PecaJosef/PCK-ST1/RPi Zero Software/pckdev/img.jpg

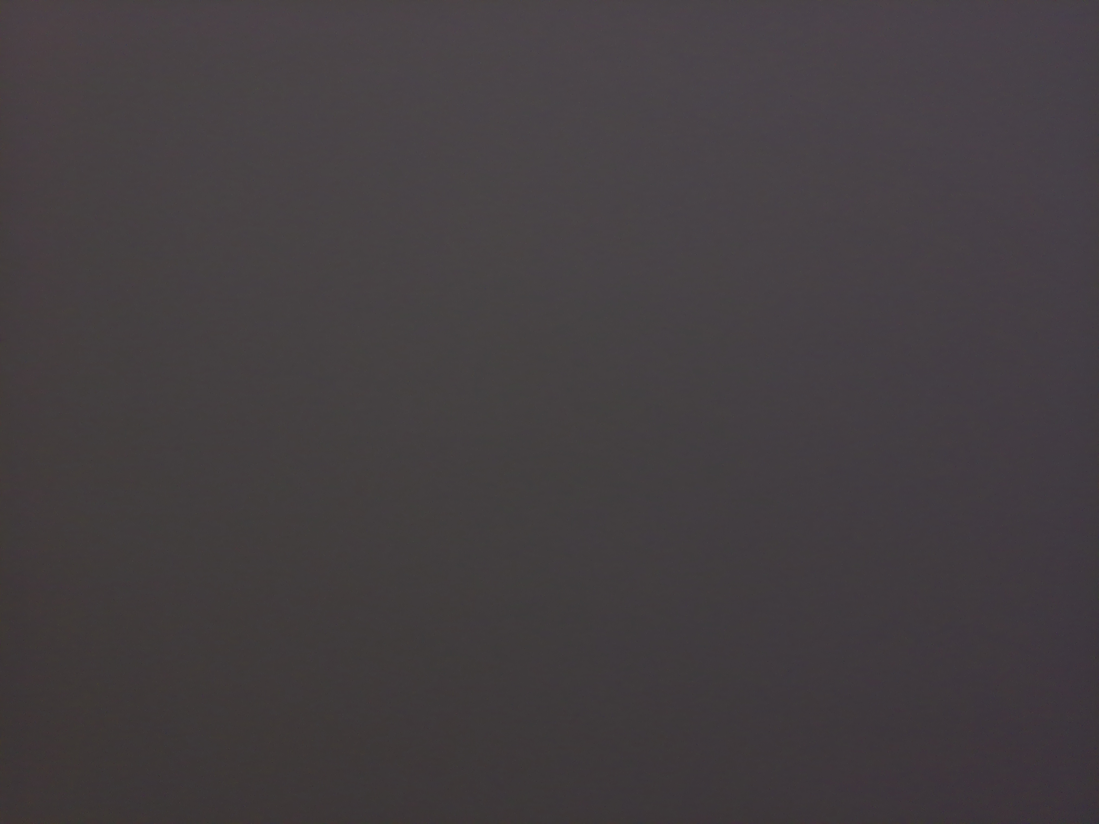
RPi Zero Software/pckdev/img.jpg
