PecaJosef/PCK-ST1/README.md

# PCK-ST1
Star tracker with automatic polar alignment
