PecaJosef/PCK-ST1/RPi Zero Software/pckdev/ncp_output.jpg

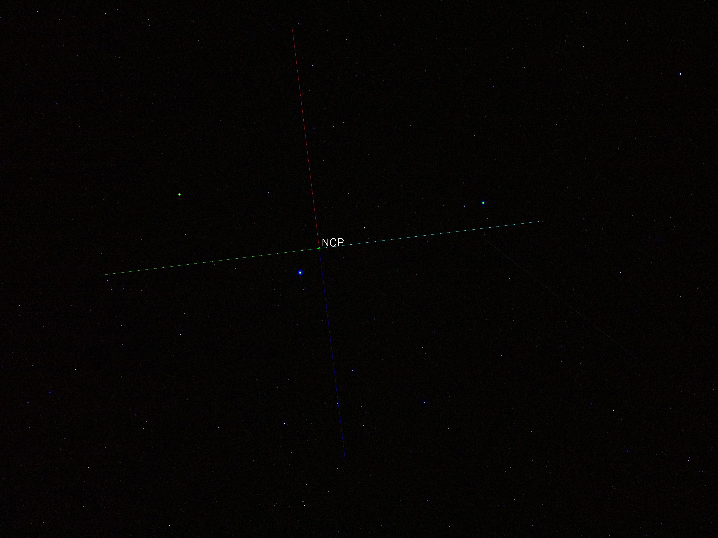
RPi Zero Software/pckdev/ncp_output.jpg
