PecaJosef/PCK-ST1/RPi Zero Software/pckdev/star_img/polaris4_1.jpg

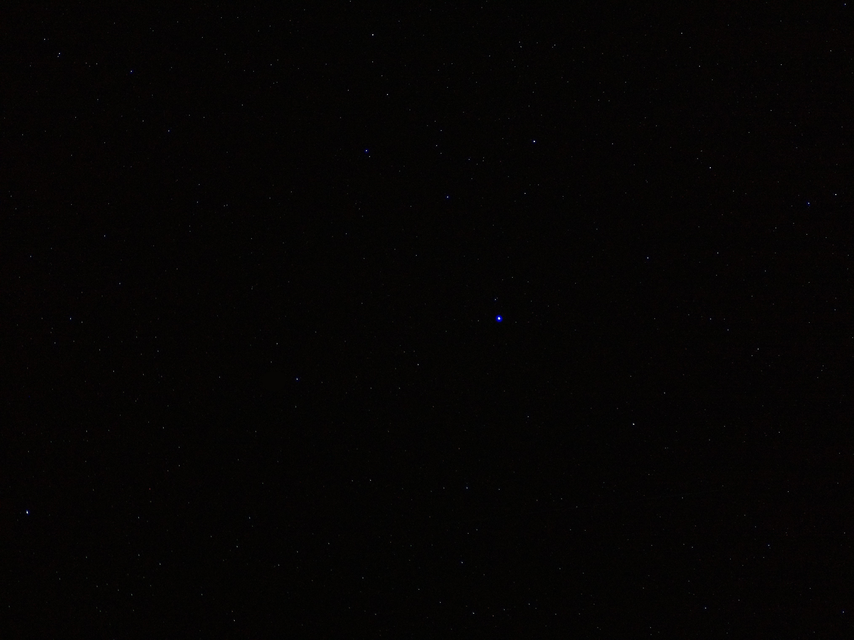
RPi Zero Software/pckdev/star_img/polaris4_1.jpg
