PecaJosef/PCK-ST1/Camera connector/Camera_connector_board/Camera_connector_board.step

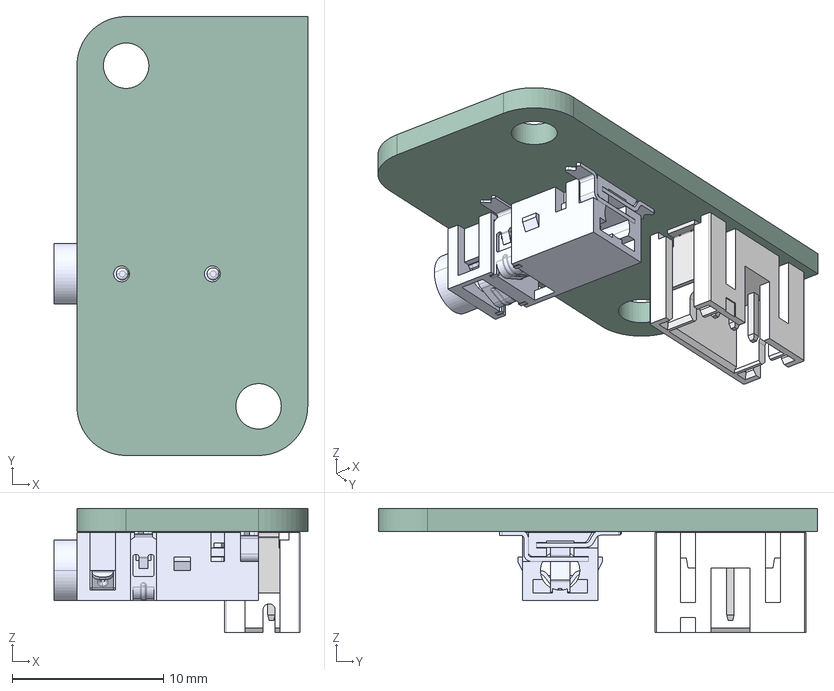
[picture p4: CAD file, 2026-01-14]
Camera connector/Camera_connector_board/Camera_connector_board.step
16.8 x 29.0 x 8.20 mm
B3B-PH-SM4-TB_LF__SN_
SJ-2524-SMT-TR
Camera_connector_board_PCB
