PecaJosef/PCK-ST1/Connector board/V0.2/Connector_board.step

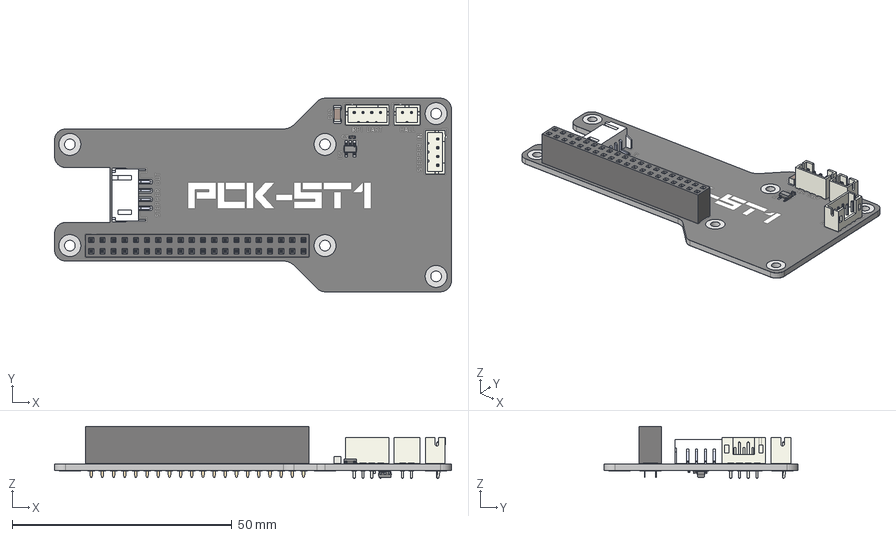
[picture p5: CAD file, 2026-02-14]
Connector board/V0.2/Connector_board.step
90.2 x 44.0 x 11.9 mm
JST_PH_B4B-PH-K_1x04_P2.00mm_Vertical x 2
JST_PH_B2B-PH-K_1x02_P2.00mm_Vertical
PinSocket_2x20_P2.54mm_Vertical
C_0402_1005Metric x 3
PinsArrayL
PinsArrayR
S4B-PH-SM4-TB_LF__SN_
C_1206_3216Metric
PinsArrayLR
R_0402_1005Metric
Connector_board_pad
Connector_board_silkscreen x 2
Connector_board_soldermask x 2
Connector_board_PCB
