PecaJosef/PCK-ST1/Hall effect endstop/PCK-HALL.step

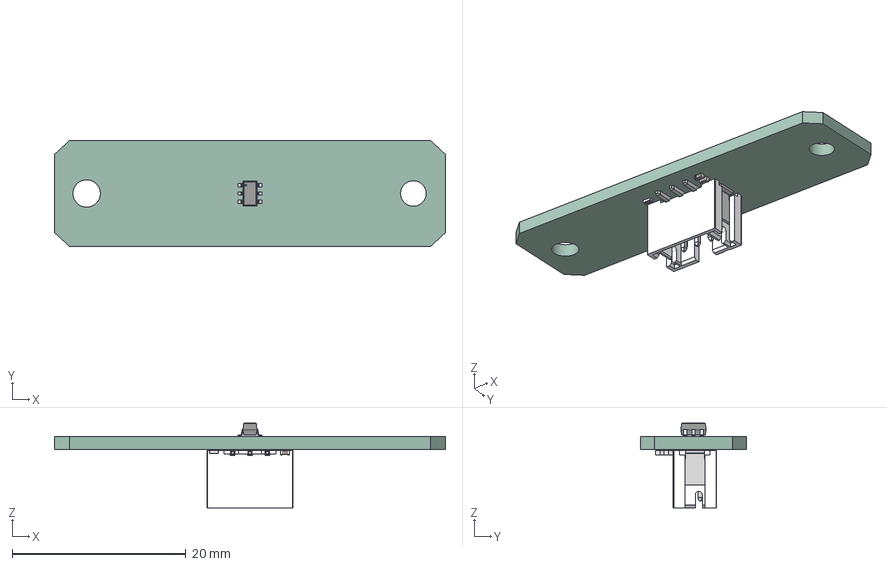
[picture p6: CAD file, 2026-01-14]
Hall effect endstop/PCK-HALL.step
45.0 x 12.2 x 9.73 mm
PinsArrayLR
B3B-PH-SM4-TB_LF__SN_
C_0402_1005Metric x 2
R_0402_1005Metric
PCK-HALL_PCB
