PecaJosef/PCK-ST1/Main board/Sketch515.dxf

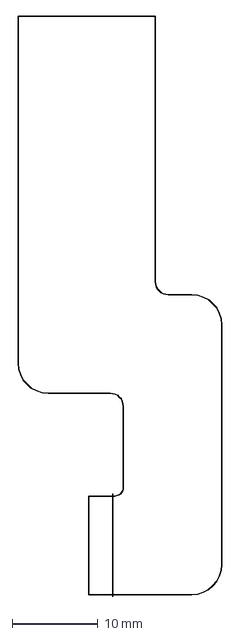
[picture p7: CAD file, 2025-07-25]
Main board/Sketch515.dxf
23.7 x 67.7 mm
