PecaJosef/PCK-ST1/Flexible camera cable v2/V2.0/PCK_Flex.step

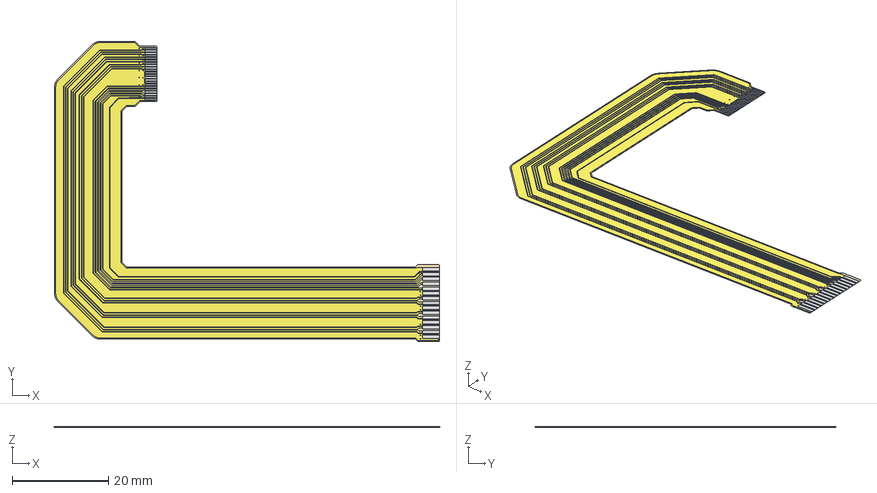
[picture p8: CAD file, 2026-02-14, an earlier design]
Flexible camera cable v2/V2.0/PCK_Flex.step
79.8 x 62.2 x 0.054 mm
PCK_Flex_copper
PCK_Flex_pad
PCK_Flex_via
PCK_Flex_PCB
