PecaJosef/PCK-ST1/Connector board/V0.2/Connector_board.kicad_pcb

## KiCad design Connector board/V0.2/Connector_board.kicad_pcb (2026-03-19)

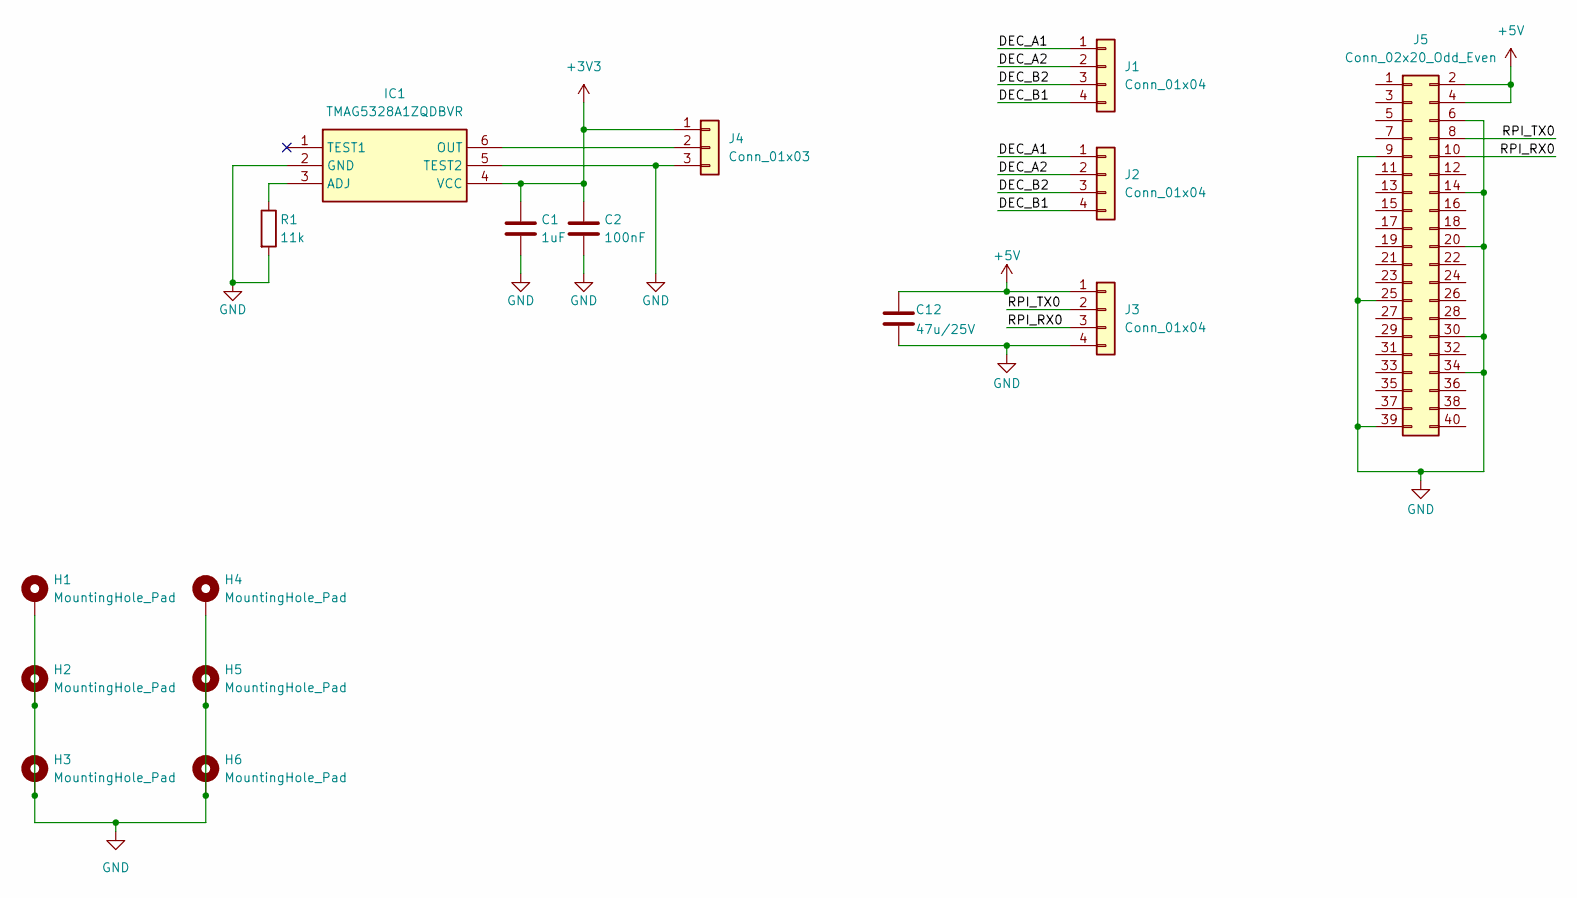
[picture p9: schematic Connector_board.kicad_sch]

Parts:
C1: 1uF; C_0402_1005Metric
C2: 100nF; C_0402_1005Metric
C12: 47u/25V; C_1206_3216Metric; Part Number C3216X5R1E476M160AC
H1, H2, H3, H4, H5, H6: MountingHole_Pad; MountingHole_2.5mm_Pad
IC1: TMAG5328A1ZQDBVR; SOT95P280X145-6N; Manufacturer_Part_Number TMAG5328A1ZQDBVR
J1, J3: Conn_01x04; JST_PH_B4B-PH-K_1x04_P2.00mm_Vertical
J2: Conn_01x04; JST_PH_S4B-PH-SM4-TB_1x04-1MP_P2.00mm_Horizontal
J4: Conn_01x03; JST_PH_B3B-PH-K_1x03_P2.00mm_Vertical
J5: Conn_02x20_Odd_Even; PinSocket_2x20_P2.54mm_Vertical
R1: 11k; R_0402_1005Metric

Connections:
+3V3: C1.1, C2.1, IC1.4 (VCC), J4.1
+5V: C12.1, J3.1, J5.2, J5.4
/DEC_A1: J1.1, J2.1
/DEC_A2: J1.2, J2.2
/DEC_B1: J1.4, J2.4
/DEC_B2: J1.3, J2.3
/RPI_RX0: J3.3, J5.10
/RPI_TX0: J3.2, J5.8
GND: C1.2, C2.2, C12.2, H1.1, H2.1, H3.1, H4.1, H5.1, H6.1, IC1.2 (GND), IC1.5 (TEST2), J3.4, J4.3, J5.6, J5.9, J5.14, J5.20, J5.25, J5.30, J5.34, J5.39, R1.2
unnamed: IC1.3 (ADJ), R1.1
unnamed: IC1.6 (OUT), J4.2

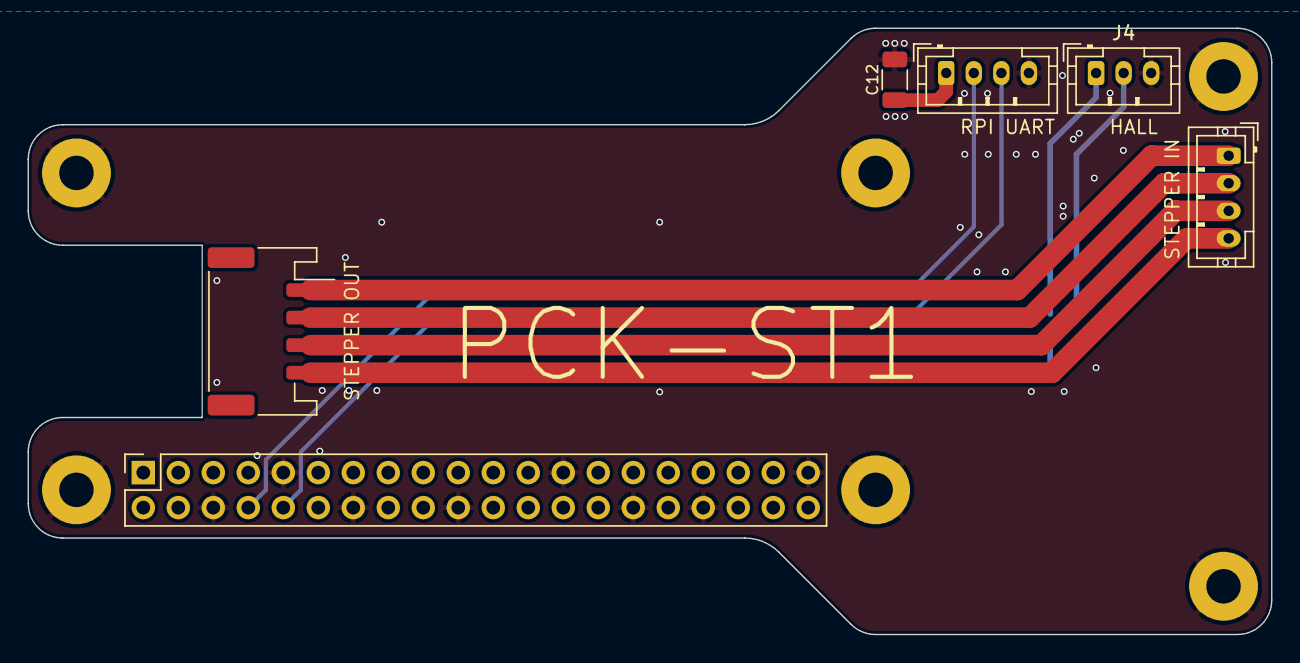
[picture p10: board Connector_board.kicad_pcb from above]

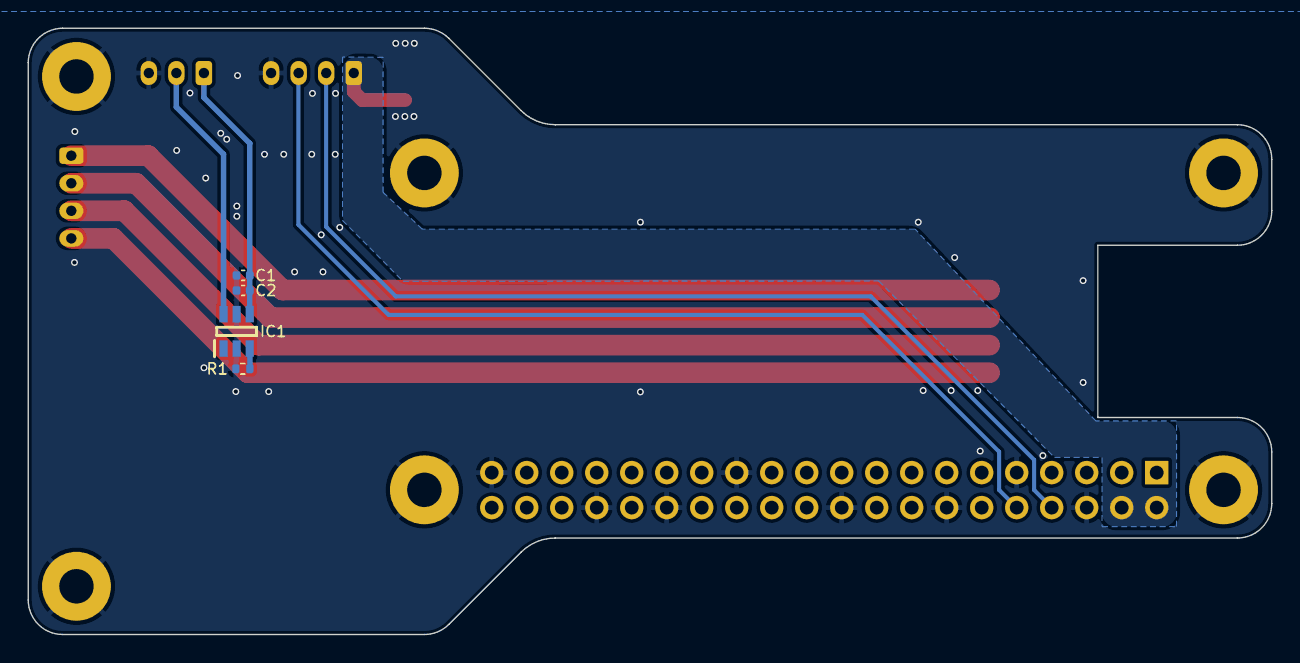
[picture p11: board Connector_board.kicad_pcb from below]

Board: 2 copper layers, 90.2 x 44.0 mm, 16 parts (4 on the bottom side), 11 nets.
