PecaJosef/PCK-ST1/Main board/PCK-ST1.kicad_pcb

## KiCad design Main board/PCK-ST1.kicad_pcb (2026-03-15)

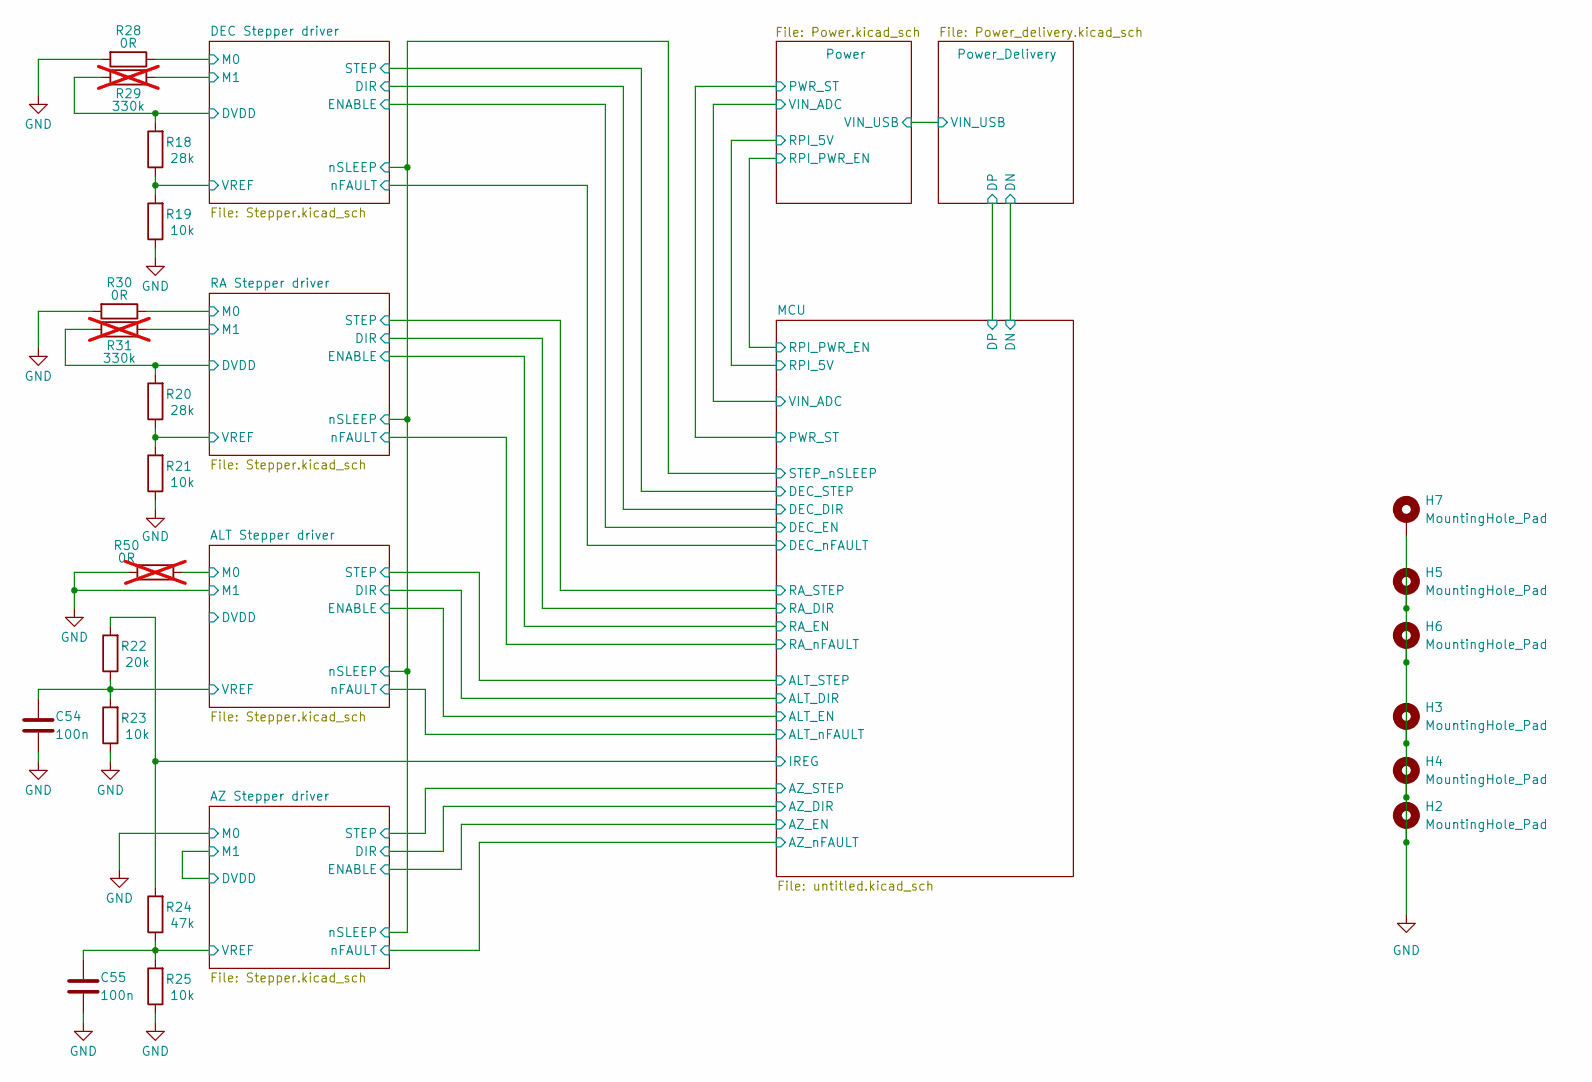
[picture p12: schematic PCK-ST1.kicad_sch]

Parts:
C54, C55: 100n; C_0402_1005Metric; Part Number GRM155R71C104JA88D
H2, H3, H4, H5, H6, H7: MountingHole_Pad; MountingHole_2.7mm_M2.5_DIN965_Pad
R18, R20: 28k; R_0402_1005Metric; Part Number CRCW040228K0FKED
R19, R21, R23, R25: 10k; R_0402_1005Metric; Part Number CRCW040210K0FKEDC
R22: 20k; R_0402_1005Metric; Part Number CRCW040220K0FKEDHP
R24: 47k; R_0402_1005Metric; Part Number CRCW040247K0FKED
R28, R30: 0R; R_0402_1005Metric; Part Number CRCW04020000Z0EDC
R29, R31: 330k; R_0402_1005Metric; Part Number CRCW0402330KFKED; not fitted
R50: 0R; R_0402_1005Metric; Part Number CRCW04020000Z0EDC; not fitted

Connections:
/ALT Stepper driver/M0: R50.2; also elsewhere on the board
/ALT Stepper driver/VREF: C54.1, R22.1, R23.2; also elsewhere on the board
/AZ Stepper driver/VREF: C55.1, R24.1, R25.2; also elsewhere on the board
/DEC Stepper driver/DVDD: R18.2, R29.1; also elsewhere on the board
/DEC Stepper driver/M0: R28.1; also elsewhere on the board
/DEC Stepper driver/M1: R29.2; also elsewhere on the board
/DEC Stepper driver/VREF: R18.1, R19.2; also elsewhere on the board
/MCU/IREG: R22.2, R24.2; also elsewhere on the board
/RA Stepper driver/DVDD: R20.2, R31.1; also elsewhere on the board
/RA Stepper driver/M0: R30.1; also elsewhere on the board
/RA Stepper driver/M1: R31.2; also elsewhere on the board
/RA Stepper driver/VREF: R20.1, R21.2; also elsewhere on the board
GND: C54.2, C55.2, H2.1, H3.1, H4.1, H5.1, H6.1, H7.1, R19.1, R21.1, R23.1, R25.1, R28.2, R30.2, R50.1; also elsewhere on the board

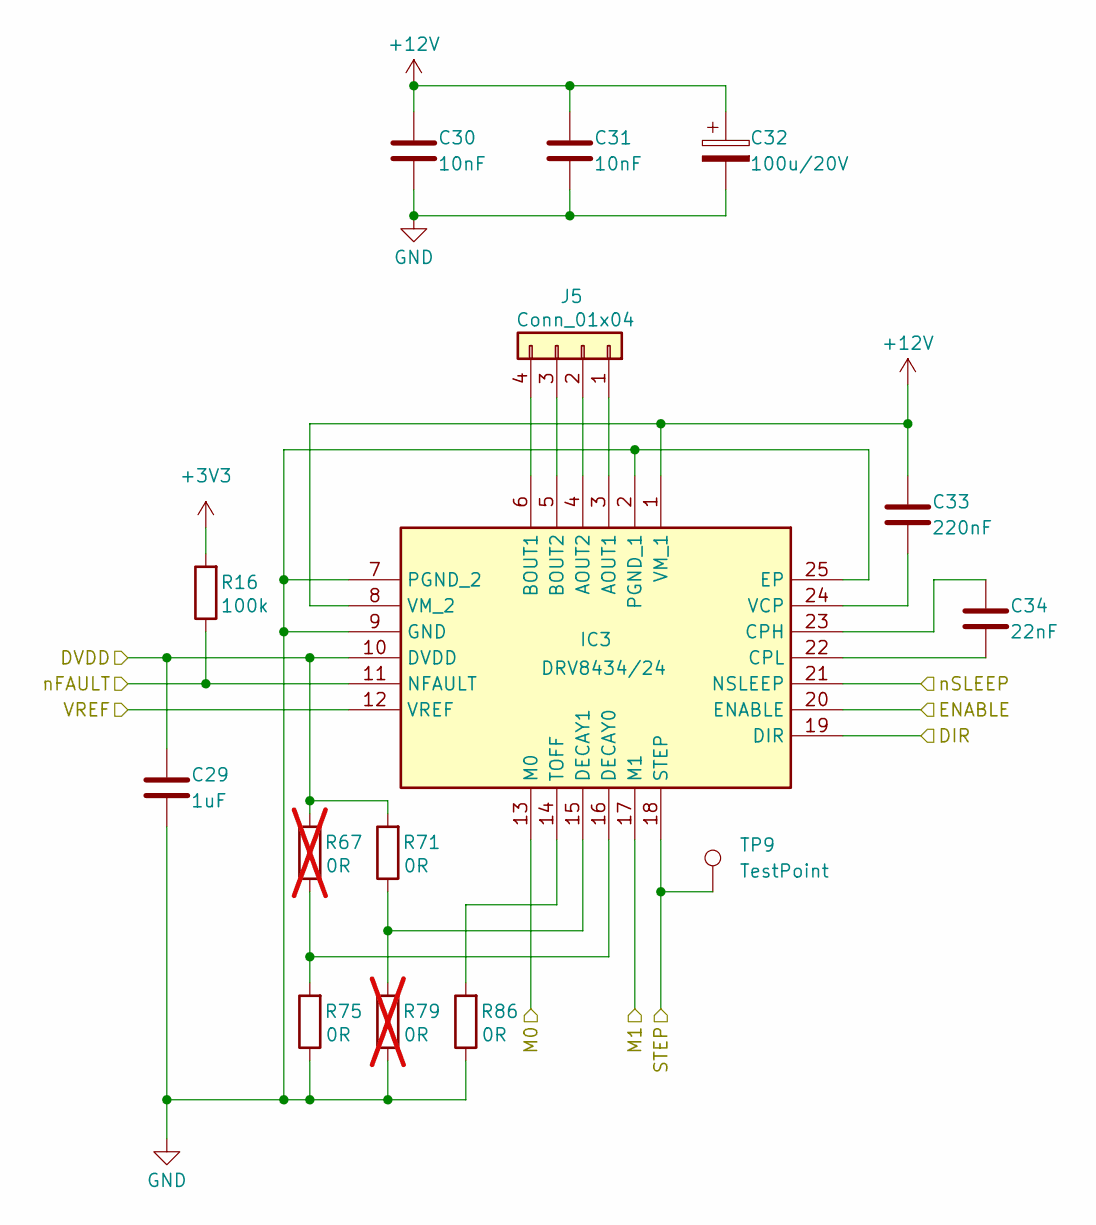
[picture p13: schematic Stepper.kicad_sch]

Parts:
C29: 1uF; C_0402_1005Metric; Part Number GRM155Z71A105KE01J
C30, C31: 10nF; C_0402_1005Metric; Part Number GRM155R71H103JA88D
C32: 100u/20V; CP_EIA-7343-15_Kemet-W; Part Number 293D107X9020D2TE3
C33: 220nF; C_0402_1005Metric; Part Number GCM155R71C224KE02J
C34: 22nF; C_0402_1005Metric; Part Number GRM155R71E223JA61D
IC3: DRV8434/24; QFN50P400X400X100-25N-D; Mouser Part Number DRV8434RGER
J5: Conn_01x04; JST_PH_B4B-PH-K_1x04_P2.00mm_Vertical
R16: 100k; R_0402_1005Metric; Part Number CRCW0402100KFKEE
R67, R79: 0R; R_0402_1005Metric; Part Number CRCW04020000Z0EDC; not fitted
R71, R75, R86: 0R; R_0402_1005Metric; Part Number CRCW04020000Z0EDC
TP9: TestPoint; TestPoint_Pad_D1.0mm

Connections:
+3V3: R16.2; also elsewhere on the board
+12V: C30.1, C31.1, C32.1, C33.1, IC3.1 (VM_1), IC3.8 (VM_2); also elsewhere on the board
/ALT Stepper driver/DIR: IC3.19 (DIR); also elsewhere on the board
/ALT Stepper driver/DVDD: C29.1, IC3.10 (DVDD), R67.2, R71.2
/ALT Stepper driver/ENABLE: IC3.20 (ENABLE); also elsewhere on the board
/ALT Stepper driver/M0: IC3.13 (M0); also elsewhere on the board
/ALT Stepper driver/STEP: IC3.18 (STEP), TP9.1; also elsewhere on the board
/ALT Stepper driver/VREF: IC3.12 (VREF); also elsewhere on the board
/ALT Stepper driver/nFAULT: IC3.11 (NFAULT), R16.1; also elsewhere on the board
/ALT Stepper driver/nSLEEP: IC3.21 (NSLEEP); also elsewhere on the board
GND: C29.2, C30.2, C31.2, C32.2, IC3.2 (PGND_1), IC3.7 (PGND_2), IC3.9 (GND), IC3.17 (M1), IC3.25 (EP), R75.1, R79.1, R86.1; also elsewhere on the board
unnamed: IC3.3 (AOUT1), J5.1
unnamed: IC3.4 (AOUT2), J5.2
unnamed: IC3.6 (BOUT1), J5.4
unnamed: IC3.5 (BOUT2), J5.3
unnamed: C34.1, IC3.23 (CPH)
unnamed: C34.2, IC3.22 (CPL)
unnamed: IC3.16 (DECAY0), R67.1, R75.2
unnamed: IC3.15 (DECAY1), R71.1, R79.2
unnamed: IC3.14 (TOFF), R86.2
unnamed: C33.2, IC3.24 (VCP)

Parts of its further copies:
C15, C28, C40: 22nF; C_0402_1005Metric; Part Number GRM155R71E223JA61D
C16, C23, C35: 1uF; C_0402_1005Metric; Part Number GRM155Z71A105KE01J
C17, C27, C39: 220nF; C_0402_1005Metric; Part Number GCM155R71C224KE02J
C18, C19, C24, C25, C36, C37: 10nF; C_0402_1005Metric; Part Number GRM155R71H103JA88D
C20, C26, C38: 100u/20V; CP_EIA-7343-15_Kemet-W; Part Number 293D107X9020D2TE3
IC1, IC2, IC4: DRV8434/24; QFN50P400X400X100-25N-D; Mouser Part Number DRV8434RGER
J3, J4, J6: Conn_01x04; JST_PH_B4B-PH-K_1x04_P2.00mm_Vertical
R14, R15, R17: 100k; R_0402_1005Metric; Part Number CRCW0402100KFKEE
R65, R66, R68, R77, R78, R80: 0R; R_0402_1005Metric; Part Number CRCW04020000Z0EDC; not fitted
R69, R70, R72, R73, R74, R76, R82, R84, R88: 0R; R_0402_1005Metric; Part Number CRCW04020000Z0EDC
TP7, TP8, TP10: TestPoint; TestPoint_Pad_D1.0mm

Connections of its further copies:
+3V3: R14.2, R15.2, R17.2; also elsewhere on the board
+12V: C17.1, C18.1, C19.1, C20.1, C24.1, C25.1, C26.1, C27.1, C36.1, C37.1, C38.1, C39.1, IC1.1 (VM_1), IC1.8 (VM_2), IC2.1 (VM_1), IC2.8 (VM_2), IC4.1 (VM_1), IC4.8 (VM_2); also elsewhere on the board
/ALT Stepper driver/nSLEEP: IC1.21 (NSLEEP), IC2.21 (NSLEEP), IC4.21 (NSLEEP); also elsewhere on the board
/AZ Stepper driver/DIR: IC4.19 (DIR); also elsewhere on the board
/AZ Stepper driver/DVDD: C35.1, IC4.10 (DVDD), IC4.17 (M1), R68.2, R72.2
/AZ Stepper driver/ENABLE: IC4.20 (ENABLE); also elsewhere on the board
/AZ Stepper driver/STEP: IC4.18 (STEP), TP10.1; also elsewhere on the board
/AZ Stepper driver/VREF: IC4.12 (VREF); also elsewhere on the board
/AZ Stepper driver/nFAULT: IC4.11 (NFAULT), R17.1; also elsewhere on the board
/DEC Stepper driver/DIR: IC1.19 (DIR); also elsewhere on the board
/DEC Stepper driver/DVDD: C16.1, IC1.10 (DVDD), R65.2, R69.2; also elsewhere on the board
/DEC Stepper driver/ENABLE: IC1.20 (ENABLE); also elsewhere on the board
/DEC Stepper driver/M0: IC1.13 (M0); also elsewhere on the board
/DEC Stepper driver/M1: IC1.17 (M1); also elsewhere on the board
/DEC Stepper driver/STEP: IC1.18 (STEP), TP7.1; also elsewhere on the board
/DEC Stepper driver/VREF: IC1.12 (VREF); also elsewhere on the board
/DEC Stepper driver/nFAULT: IC1.11 (NFAULT), R14.1; also elsewhere on the board
/MCU/RA_DIR: IC2.19 (DIR); also elsewhere on the board
/MCU/RA_EN: IC2.20 (ENABLE); also elsewhere on the board
/MCU/RA_STEP: IC2.18 (STEP), TP8.1; also elsewhere on the board
/MCU/RA_nFAULT: IC2.11 (NFAULT), R15.1; also elsewhere on the board
/RA Stepper driver/DVDD: C23.1, IC2.10 (DVDD), R66.2, R70.2; also elsewhere on the board
/RA Stepper driver/M0: IC2.13 (M0); also elsewhere on the board
/RA Stepper driver/M1: IC2.17 (M1); also elsewhere on the board
/RA Stepper driver/VREF: IC2.12 (VREF); also elsewhere on the board
GND: C16.2, C18.2, C19.2, C20.2, C23.2, C24.2, C25.2, C26.2, C35.2, C36.2, C37.2, C38.2, IC1.2 (PGND_1), IC1.7 (PGND_2), IC1.9 (GND), IC1.25 (EP), IC2.2 (PGND_1), IC2.7 (PGND_2), IC2.9 (GND), IC2.25 (EP), IC4.2 (PGND_1), IC4.7 (PGND_2), IC4.9 (GND), IC4.13 (M0), IC4.25 (EP), R73.1, R74.1, R76.1, R77.1, R78.1, R80.1, R82.1, R84.1, R88.1; also elsewhere on the board
unnamed: IC1.3 (AOUT1), J3.1
unnamed: IC1.4 (AOUT2), J3.2
unnamed: IC1.6 (BOUT1), J3.4
unnamed: IC1.5 (BOUT2), J3.3
unnamed: C15.1, IC1.23 (CPH)
unnamed: C15.2, IC1.22 (CPL)
unnamed: IC1.16 (DECAY0), R65.1, R73.2
unnamed: IC1.15 (DECAY1), R69.1, R77.2
unnamed: IC1.14 (TOFF), R82.2
unnamed: C17.2, IC1.24 (VCP)
unnamed: IC2.3 (AOUT1), J4.1
unnamed: IC2.4 (AOUT2), J4.2
unnamed: IC2.6 (BOUT1), J4.4
unnamed: IC2.5 (BOUT2), J4.3
unnamed: C28.1, IC2.23 (CPH)
unnamed: C28.2, IC2.22 (CPL)
unnamed: IC2.16 (DECAY0), R66.1, R74.2
unnamed: IC2.15 (DECAY1), R70.1, R78.2
unnamed: IC2.14 (TOFF), R84.2
unnamed: C27.2, IC2.24 (VCP)
unnamed: IC4.3 (AOUT1), J6.1
unnamed: IC4.4 (AOUT2), J6.2
unnamed: IC4.6 (BOUT1), J6.4
unnamed: IC4.5 (BOUT2), J6.3
unnamed: C40.1, IC4.23 (CPH)
unnamed: C40.2, IC4.22 (CPL)
unnamed: IC4.16 (DECAY0), R68.1, R76.2
unnamed: IC4.15 (DECAY1), R72.1, R80.2
unnamed: IC4.14 (TOFF), R88.2
unnamed: C39.2, IC4.24 (VCP)

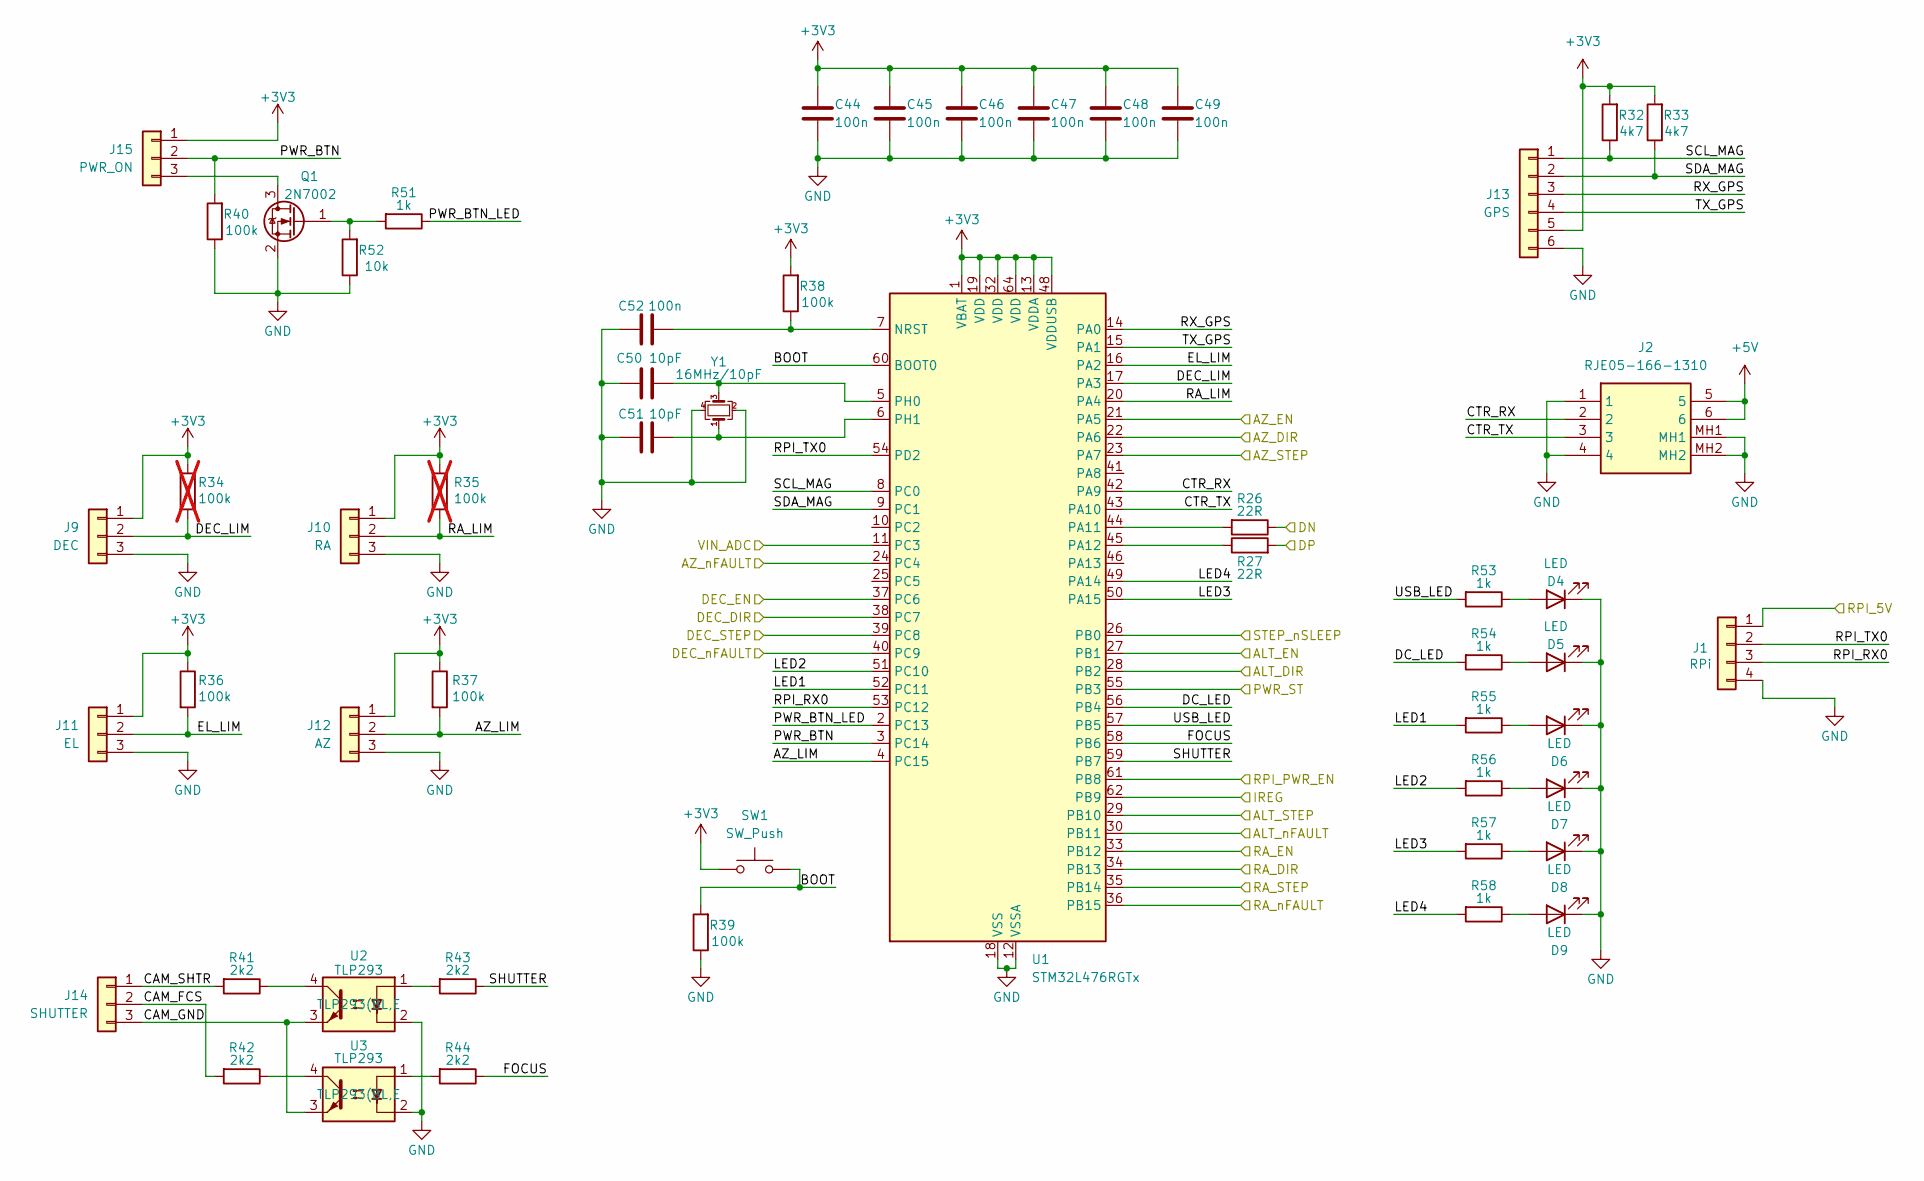
[picture p14: schematic untitled.kicad_sch]

Parts:
C44, C45, C46, C47, C48, C49, C52: 100n; C_0402_1005Metric; Part Number GRM155R71C104JA88D
C50, C51: 10pF; C_0402_1005Metric; Part Number GCM1555C1H100FA16D
D4, D5, D6, D7, D8, D9: LED; LED_0603_1608Metric; Part Number SML-D12U1WT86
J1: RPi; JST_PH_B4B-PH-K_1x04_P2.00mm_Vertical
J2: RJE05-166-1310; RJE051661310; Mouser Part Number 523-RJE05-166-1310
J9: DEC; JST_PH_B3B-PH-K_1x03_P2.00mm_Vertical
J10: RA; JST_PH_B3B-PH-K_1x03_P2.00mm_Vertical
J11: EL; JST_PH_B3B-PH-K_1x03_P2.00mm_Vertical
J12: AZ; JST_PH_B3B-PH-K_1x03_P2.00mm_Vertical
J13: GPS; JST_PH_B6B-PH-K_1x06_P2.00mm_Vertical
J14: SHUTTER; JST_PH_B3B-PH-K_1x03_P2.00mm_Vertical
J15: PWR_ON; JST_PH_B3B-PH-K_1x03_P2.00mm_Vertical
Q1: 2N7002; SOT-323_SC-70; Part Number 2N7002AKW-QX
R26, R27: 22R; R_0402_1005Metric; Part Number CRCW040222R0FKED
R32, R33: 4k7; R_0402_1005Metric; Part Number CRCW04024K70FKED
R34, R35: 100k; R_0402_1005Metric; Part Number CRCW0402100KFKEE; not fitted
R36, R37, R38, R39, R40: 100k; R_0402_1005Metric; Part Number CRCW0402100KFKEE
R41, R42, R43, R44: 2k2; R_0402_1005Metric; Part Number CRCW04022K20FKEDC
R51, R53, R54, R55, R56, R57, R58: 1k; R_0402_1005Metric; Part Number CRCW04021K00FKED
R52: 10k; R_0402_1005Metric; Part Number CRCW040210K0FKEDC
SW1: SW_Push; SKRTLAE010
U1: STM32L476RGTx; LQFP-64_10x10mm_P0.5mm; Part Number STM32L476RGT6
U2, U3: TLP293; SOIC-4_4.55x2.6mm_P1.27mm; Part Number TLP293(BL,E
Y1: 16MHz/10pF; Crystal_SMD_2016-4Pin_2.0x1.6mm; Part Number ECS1601037B2CTNTR

Connections:
+3V3: C44.1, C45.1, C46.1, C47.1, C48.1, C49.1, J9.1, J10.1, J11.1, J12.1, J13.5, J15.1, R32.2, R33.2, R34.1, R35.1, R36.1, R37.1, R38.2, SW1.1, U1.1 (VBAT), U1.13 (VDDA), U1.19 (VDD), U1.32 (VDD), U1.48 (VDDUSB), U1.64 (VDD); also elsewhere on the board
+5V: J2.5, J2.6; also elsewhere on the board
/ALT Stepper driver/DIR: U1.28 (PB2); also elsewhere on the board
/ALT Stepper driver/ENABLE: U1.27 (PB1); also elsewhere on the board
/ALT Stepper driver/STEP: U1.29 (PB10); also elsewhere on the board
/ALT Stepper driver/nFAULT: U1.30 (PB11); also elsewhere on the board
/ALT Stepper driver/nSLEEP: U1.26 (PB0); also elsewhere on the board
/AZ Stepper driver/DIR: U1.22 (PA6); also elsewhere on the board
/AZ Stepper driver/ENABLE: U1.21 (PA5); also elsewhere on the board
/AZ Stepper driver/STEP: U1.23 (PA7); also elsewhere on the board
/AZ Stepper driver/nFAULT: U1.24 (PC4); also elsewhere on the board
/DEC Stepper driver/DIR: U1.38 (PC7); also elsewhere on the board
/DEC Stepper driver/ENABLE: U1.37 (PC6); also elsewhere on the board
/DEC Stepper driver/STEP: U1.39 (PC8); also elsewhere on the board
/DEC Stepper driver/nFAULT: U1.40 (PC9); also elsewhere on the board
/MCU/AZ_LIM: J12.2, R37.2, U1.4 (PC15)
/MCU/BOOT: R39.2, SW1.2, U1.60 (BOOT0)
/MCU/CAM_FCS: J14.2, R42.2
/MCU/CAM_GND: J14.3, U2.3, U3.3
/MCU/CAM_SHTR: J14.1, R41.2
/MCU/CTR_RX: J2.2, U1.42 (PA9)
/MCU/CTR_TX: J2.3, U1.43 (PA10)
/MCU/DC_LED: R54.2, U1.56 (PB4)
/MCU/DEC_LIM: J9.2, R34.2, U1.17 (PA3)
/MCU/DN: R26.1; also elsewhere on the board
/MCU/DP: R27.2; also elsewhere on the board
/MCU/EL_LIM: J11.2, R36.2, U1.16 (PA2)
/MCU/FOCUS: R44.1, U1.58 (PB6)
/MCU/IREG: U1.62 (PB9); also elsewhere on the board
/MCU/LED1: R55.2, U1.52 (PC11)
/MCU/LED2: R56.2, U1.51 (PC10)
/MCU/LED3: R57.2, U1.50 (PA15)
/MCU/LED4: R58.2, U1.49 (PA14)
/MCU/PWR_BTN: J15.2, R40.2, U1.3 (PC14)
/MCU/PWR_BTN_LED: R51.1, U1.2 (PC13)
/MCU/RA_DIR: U1.34 (PB13); also elsewhere on the board
/MCU/RA_EN: U1.33 (PB12); also elsewhere on the board
/MCU/RA_LIM: J10.2, R35.2, U1.20 (PA4)
/MCU/RA_STEP: U1.35 (PB14); also elsewhere on the board
/MCU/RA_nFAULT: U1.36 (PB15); also elsewhere on the board
/MCU/RPI_5V: J1.1; also elsewhere on the board
/MCU/RPI_PWR_EN: U1.61 (PB8); also elsewhere on the board
/MCU/RPI_RX0: J1.3, U1.53 (PC12)
/MCU/RPI_TX0: J1.2, U1.54 (PD2)
/MCU/RX_GPS: J13.3, U1.14 (PA0)
/MCU/SCL_MAG: J13.1, R32.1, U1.8 (PC0)
/MCU/SDA_MAG: J13.2, R33.1, U1.9 (PC1)
/MCU/SHUTTER: R43.1, U1.59 (PB7)
/MCU/TX_GPS: J13.4, U1.15 (PA1)
/MCU/USB_LED: R53.2, U1.57 (PB5)
/MCU/VIN_ADC: U1.11 (PC3); also elsewhere on the board
/Power/PWR_STATE: U1.55 (PB3); also elsewhere on the board
GND: C44.2, C45.2, C46.2, C47.2, C48.2, C49.2, C50.1, C51.1, C52.1, D4.1 (K), D5.1 (K), D6.1 (K), D7.1 (K), D8.1 (K), D9.1 (K), J1.4, J2.1, J2.4, J2.MH1, J2.MH2, J9.3, J10.3, J11.3, J12.3, J13.6, Q1.2 (S), R39.1, R40.1, R52.1, U1.12 (VSSA), U1.18 (VSS), U1.31 (VSS), U1.47 (VSS), U1.63 (VSS), U2.2, U3.2, Y1.2, Y1.4; also elsewhere on the board
unnamed: D4.2 (A), R53.1
unnamed: D5.2 (A), R54.1
unnamed: D6.2 (A), R55.1
unnamed: D7.2 (A), R56.1
unnamed: D8.2 (A), R57.1
unnamed: D9.2 (A), R58.1
unnamed: J15.3, Q1.3 (D)
unnamed: Q1.1 (G), R51.2, R52.2
unnamed: R41.1, U2.4
unnamed: R42.1, U3.4
unnamed: R43.2, U2.1
unnamed: R44.2, U3.1
unnamed: C52.2, R38.1, U1.7 (NRST)
unnamed: R26.2, U1.44 (PA11)
unnamed: R27.1, U1.45 (PA12)
unnamed: C50.2, U1.5 (PH0), Y1.3
unnamed: C51.2, U1.6 (PH1), Y1.1

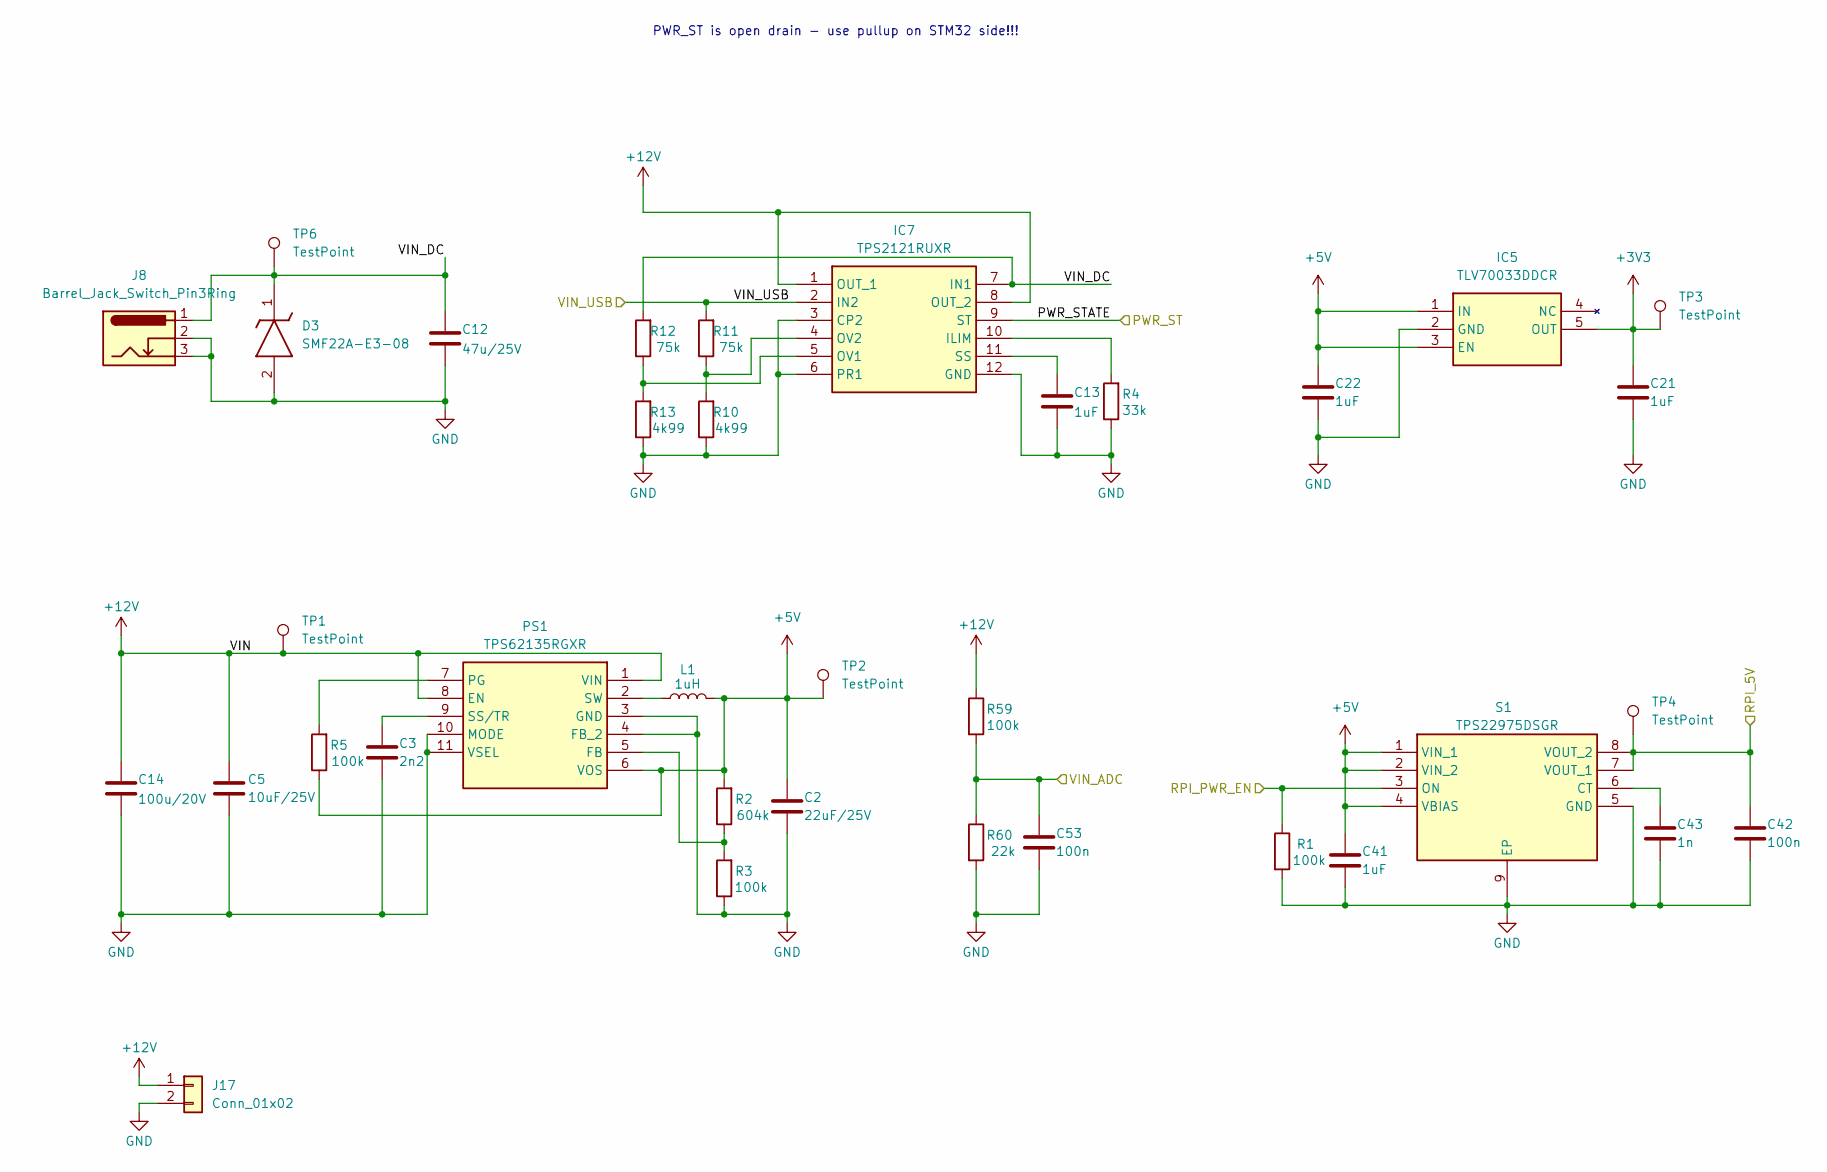
[picture p15: schematic Power.kicad_sch]

Parts:
C2: 22uF/25V; C_0805_2012Metric; Part Number CL21A226MAYNNNE
C3: 2n2; C_0402_1005Metric; Part Number GRM155R71H222JA01J
C5: 10uF/25V; C_0603_1608Metric; Part Number GRM188R61E106KA73J
C12: 47u/25V; C_1206_3216Metric; Part Number C3216X5R1E476M160AC
C13, C21, C22, C41: 1uF; C_0402_1005Metric; Part Number GRM155Z71A105KE01J
C14: 100u/20V; CP_EIA-7343-15_Kemet-W; Part Number 293D107X9020D2TE3
C42, C53: 100n; C_0402_1005Metric; Part Number GRM155R71C104JA88D
C43: 1n; C_0402_1005Metric; Part Number GRT1555C1H102FA02D
D3: SMF22A-E3-08; SODFL3718X108N; Mouser Part Number 78-SMF22A-E3-08
IC5: TLV70033DDCR; SOT95P280X110-5N; Mouser Part Number 595-TLV70033DDCR
IC7: TPS2121RUXR; Mouser Part Number 595-TPS2121RUXR
J8: Barrel_Jack_Switch_Pin3Ring; BarrelJack_GCT_DCJ200-10-A_Horizontal
J17: Conn_01x02; JST_PH_B2B-PH-K_1x02_P2.00mm_Vertical
L1: 1uH; L_Coilcraft_XAL4020-XXX; Part Number 74439323010
PS1: TPS62135RGXR; TPS621361RGXT; Mouser Part Number 595-TPS62135RGXR
R1: 100k; R_0402_1005Metric; Part Number CRCW040222K0FKEDHP
R2: 604k; R_0402_1005Metric; Part Number CRCW0402604KFKEDC
R3, R5, R59: 100k; R_0402_1005Metric; Part Number CRCW0402100KFKEE
R4: 33k; R_0402_1005Metric; Part Number CRCW040233K0FKEDHP
R10, R13: 4k99; R_0402_1005Metric; Part Number CRCW04024K99FKED
R11, R12: 75k; R_0402_1005Metric; Part Number CRCW040275K0FKED
R60: 22k; R_0402_1005Metric; Part Number CRCW040222K0FKEDHP
S1: TPS22975DSGR; SON50P200X200X80-9N; Mouser Part Number 595-TPS22975DSGR
TP1, TP2, TP3, TP4, TP6: TestPoint; TestPoint_Pad_D1.0mm

Connections:
+3V3: C21.1, IC5.5 (OUT), TP3.1; also elsewhere on the board
+5V: C2.1, C22.1, C41.1, IC5.1 (IN), IC5.3 (EN), L1.2, PS1.6 (VOS), R2.2, R5.1, S1.1 (VIN_1), S1.2 (VIN_2), S1.4 (VBIAS), TP2.1; also elsewhere on the board
+12V: C5.1, C14.1, IC7.1 (OUT_1), IC7.8 (OUT_2), J17.1, PS1.1 (VIN), PS1.8 (EN), R59.1, TP1.1; also elsewhere on the board
/MCU/RPI_5V: C42.1, S1.7 (VOUT_1), S1.8 (VOUT_2), TP4.1; also elsewhere on the board
/MCU/RPI_PWR_EN: R1.1, S1.3 (ON); also elsewhere on the board
/MCU/VIN_ADC: C53.1, R59.2, R60.1; also elsewhere on the board
/Power/PWR_STATE: IC7.9 (ST); also elsewhere on the board
/Power/VIN_DC: C12.1, D3.1 (K), IC7.7 (IN1), J8.1, R12.2, TP6.1
/Power/VIN_USB: IC7.2 (IN2), R11.2; also elsewhere on the board
GND: C2.2, C3.2, C5.2, C12.2, C13.2, C14.2, C21.2, C22.2, C41.2, C42.2, C43.2, C53.2, D3.2 (A), IC5.2 (GND), IC7.3 (CP2), IC7.6 (PR1), IC7.12 (GND), J8.2, J8.3, J17.2, PS1.3 (GND), PS1.4 (FB_2), PS1.10 (MODE), PS1.11 (VSEL), R1.2, R3.1, R4.1, R10.1, R13.1, R60.2, S1.5 (GND), S1.9 (EP); also elsewhere on the board
unnamed: IC7.10 (ILIM), R4.2
unnamed: IC7.5 (OV1), R12.1, R13.2
unnamed: IC7.4 (OV2), R10.2, R11.1
unnamed: C13.1, IC7.11 (SS)
unnamed: PS1.5 (FB), R2.1, R3.2
unnamed: PS1.7 (PG), R5.2
unnamed: C3.1, PS1.9 (SS/TR)
unnamed: L1.1, PS1.2 (SW)
unnamed: C43.1, S1.6 (CT)

Notes on the sheet:
PWR_ST is open drain - use pullup on STM32 side!!!
