PecaJosef/PCK-ST1/Main board/PCK-ST1.kicad_pcb

## KiCad design Main board/PCK-ST1.kicad_pcb (continued)

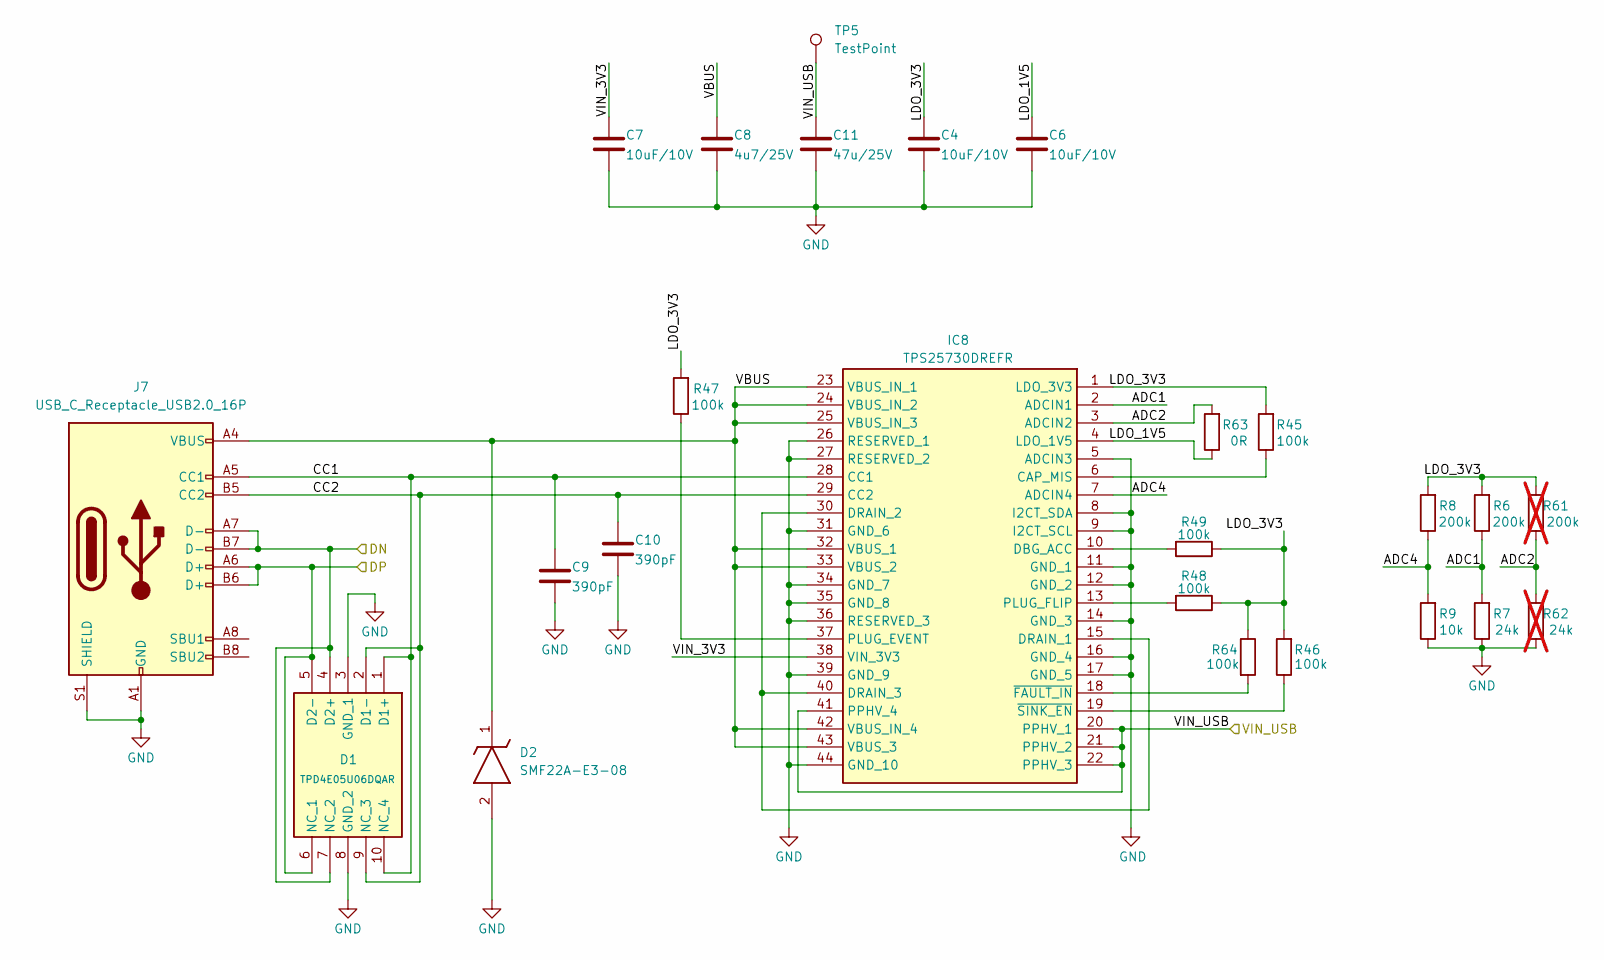
[picture p16: schematic Power_delivery.kicad_sch]

Parts:
C4, C6, C7: 10uF/10V; C_0402_1005Metric; Part Number GRM155R61A106ME11D
C8: 4u7/25V; C_0603_1608Metric; Part Number GRM188R61E475KE11D
C9, C10: 390pF; C_0402_1005Metric; Part Number GRM1555C2A391JE01D
C11: 47u/25V; C_1206_3216Metric; Part Number C3216X5R1E476M160AC
D1: TPD4E05U06DQAR; DQA_R-PUSON-N10_; Mouser Part Number 595-TPD4E05U06DQAR
D2: SMF22A-E3-08; SODFL3718X108N; Mouser Part Number 78-SMF22A-E3-08
IC8: TPS25730DREFR; Mouser Part Number 595-TPS25730DREFR
J7: USB_C_Receptacle_USB2.0_16P; USB_C_Receptacle_HCTL_HC-TYPE-C-16P-01A
R6, R8: 200k; R_0402_1005Metric; Part Number CRCW0402200KFKEDHP
R7: 24k; R_0402_1005Metric; Part Number CRCW040224K0FKEDC
R9: 10k; R_0402_1005Metric; Part Number CRCW040210K0FKEDC
R45, R46, R47, R48, R49, R64: 100k; R_0402_1005Metric; Part Number CRCW0402100KFKEE
R61: 200k; R_0402_1005Metric; Part Number CRCW0402200KFKEDHP; not fitted
R62: 24k; R_0402_1005Metric; Part Number CRCW040224K0FKEDC; not fitted
R63: 0R; R_0402_1005Metric; Part Number CRCW04020000Z0EDC
TP5: TestPoint; TestPoint_Pad_D1.0mm

Connections:
/MCU/DN: D1.4 (D2+), D1.7 (NC_2), J7.A7 (D-), J7.B7 (D-); also elsewhere on the board
/MCU/DP: D1.5 (D2-), D1.6 (NC_1), J7.A6 (D+), J7.B6 (D+); also elsewhere on the board
/Power/VIN_USB: C11.1, IC8.20 (PPHV_1), IC8.21 (PPHV_2), IC8.22 (PPHV_3), IC8.41 (PPHV_4), TP5.1; also elsewhere on the board
/Power_Delivery/ADC1: IC8.2 (ADCIN1), R6.1, R7.2
/Power_Delivery/ADC2: IC8.3 (ADCIN2), R61.1, R62.2, R63.2
/Power_Delivery/ADC4: IC8.7 (ADCIN4), R8.1, R9.2
/Power_Delivery/CC1: C9.1, D1.1 (D1+), D1.10 (NC_4), IC8.28 (CC1), J7.A5 (CC1)
/Power_Delivery/CC2: C10.1, D1.2 (D1-), D1.9 (NC_3), IC8.29 (CC2), J7.B5 (CC2)
/Power_Delivery/LDO_1V5: C6.1, IC8.4 (LDO_1V5), R63.1
/Power_Delivery/LDO_3V3: C4.1, IC8.1 (LDO_3V3), R6.2, R8.2, R45.2, R46.2, R47.2, R48.1, R49.1, R61.2, R64.1
/Power_Delivery/VBUS: C8.1, D2.1 (K), IC8.23 (VBUS_IN_1), IC8.24 (VBUS_IN_2), IC8.25 (VBUS_IN_3), IC8.32 (VBUS_1), IC8.33 (VBUS_2), IC8.42 (VBUS_IN_4), IC8.43 (VBUS_3), J7.A4 (VBUS), J7.A9 (VBUS), J7.B4 (VBUS), J7.B9 (VBUS)
/Power_Delivery/VIN_3V3: C7.1, IC8.38 (VIN_3V3)
GND: C4.2, C6.2, C7.2, C8.2, C9.2, C10.2, C11.2, D1.3 (GND_1), D1.8 (GND_2), D2.2 (A), IC8.5 (ADCIN3), IC8.8 (I2CT_SDA), IC8.9 (I2CT_SCL), IC8.11 (GND_1), IC8.12 (GND_2), IC8.14 (GND_3), IC8.16 (GND_4), IC8.17 (GND_5), IC8.26 (RESERVED_1), IC8.27 (RESERVED_2), IC8.31 (GND_6), IC8.34 (GND_7), IC8.35 (GND_8), IC8.36 (RESERVED_3), IC8.39 (GND_9), IC8.44 (GND_10), J7.A1 (GND), J7.A12 (GND), J7.B1 (GND), J7.B12 (GND), J7.S1 (SHIELD), R7.1, R9.1, R62.1; also elsewhere on the board
unnamed: IC8.6 (CAP_MIS), R45.1
unnamed: IC8.10 (DBG_ACC), R49.2
unnamed: IC8.15 (DRAIN_1), IC8.30 (DRAIN_2), IC8.40 (DRAIN_3)
unnamed: IC8.37 (PLUG_EVENT), R47.1
unnamed: IC8.13 (PLUG_FLIP), R48.2
unnamed: IC8.18 (~FAULT_IN), R64.2
unnamed: IC8.19 (~SINK_EN), R46.1

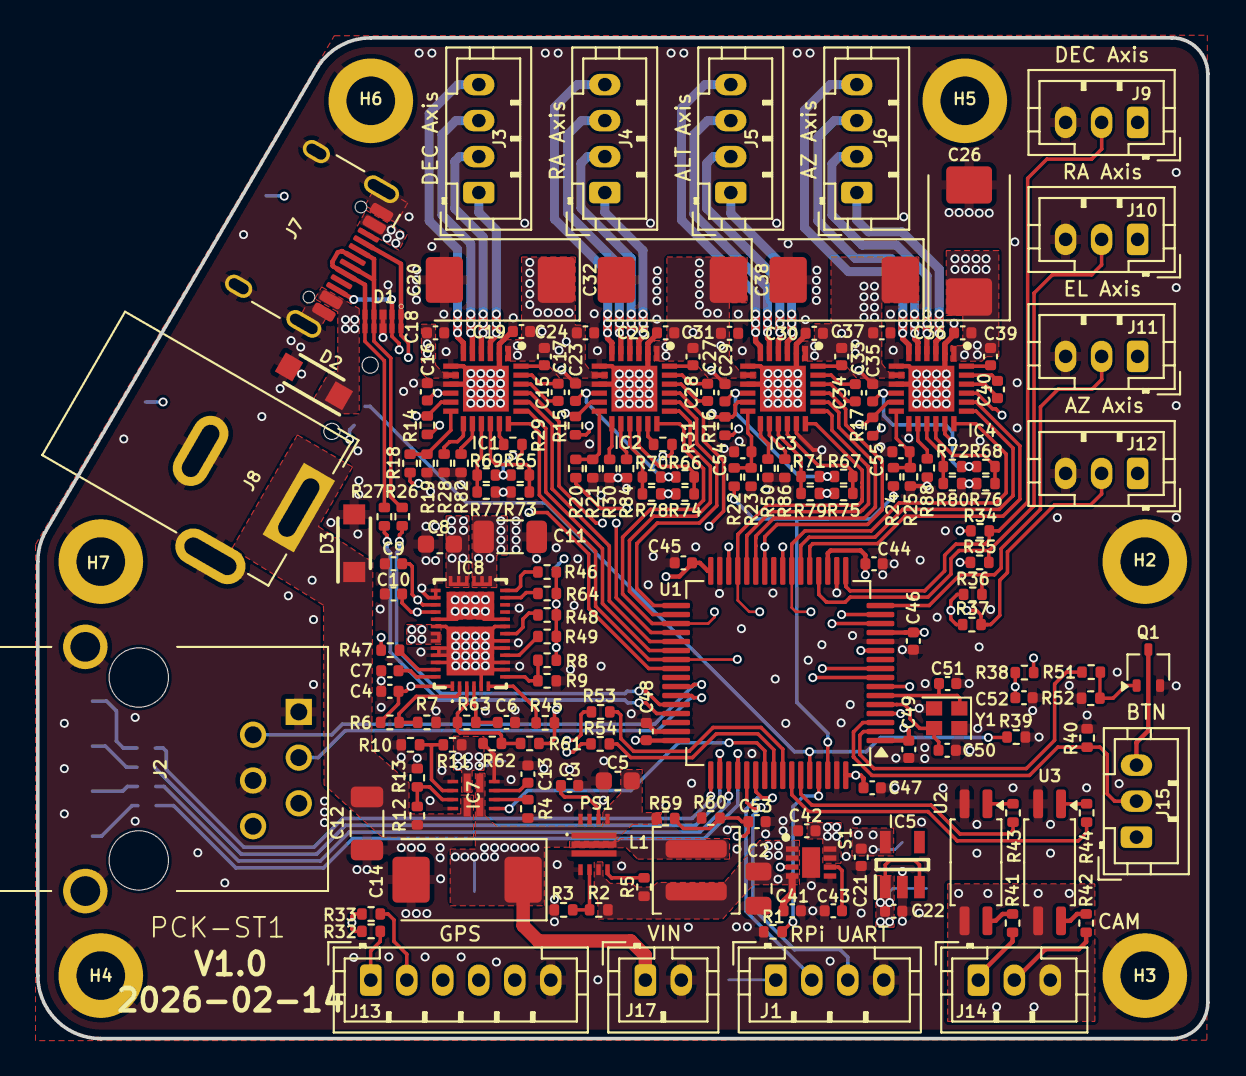
[picture p17: board PCK-ST1.kicad_pcb from above]

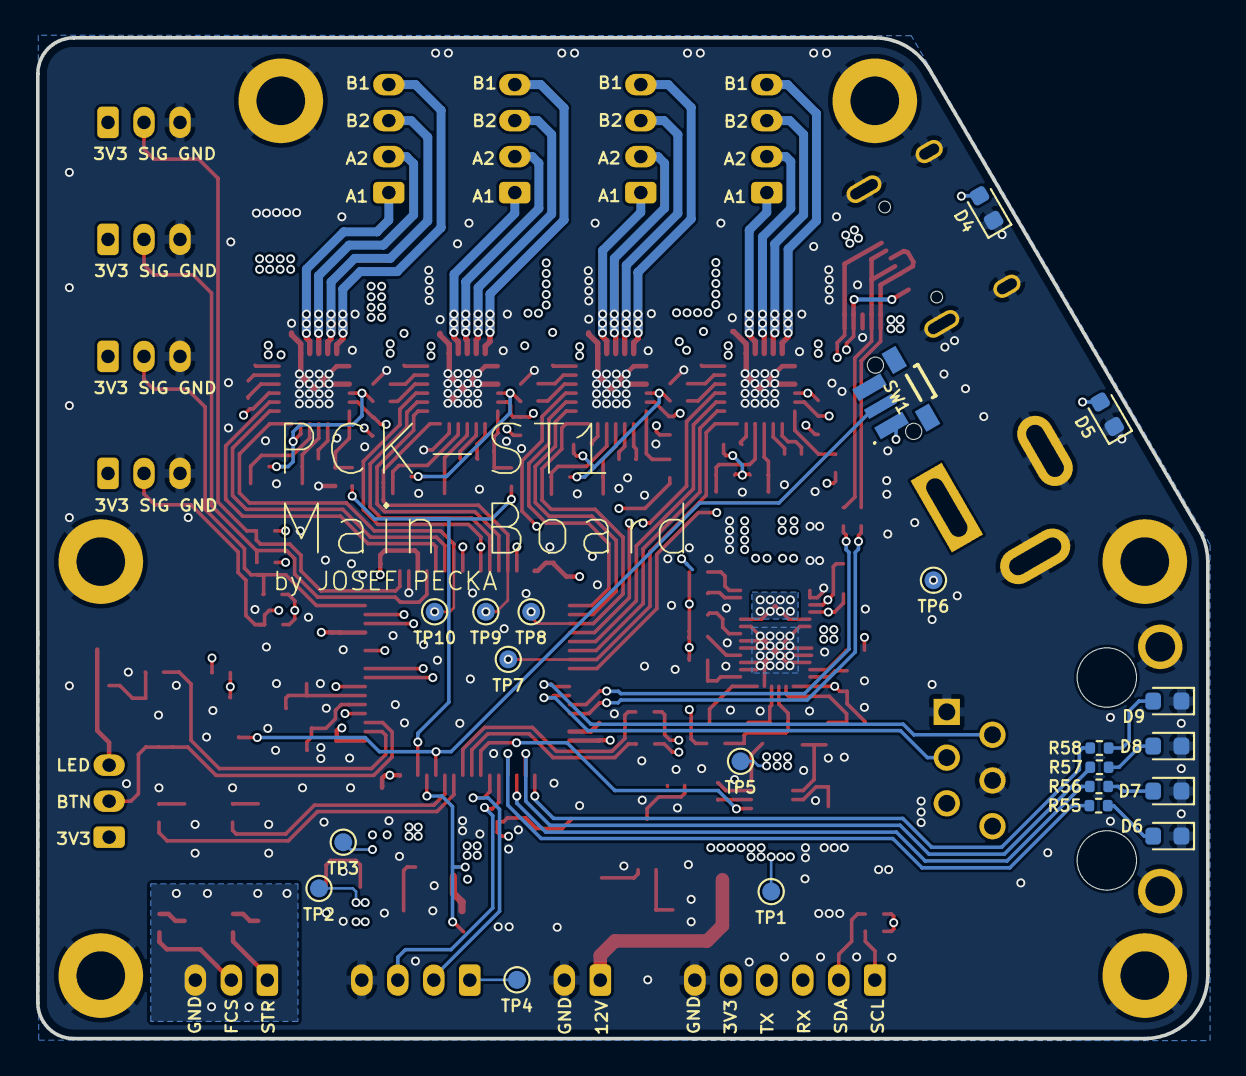
[picture p18: board PCK-ST1.kicad_pcb from below]

Board: 4 copper layers, 65.0 x 55.6 mm, 195 parts (21 on the bottom side), 151 nets.
