PecaJosef/PCK-ST1/Camera connector/Camera_connector_board/Camera_connector_board.kicad_pcb

## KiCad design Camera connector/Camera_connector_board/Camera_connector_board.kicad_pcb (2026-01-18)

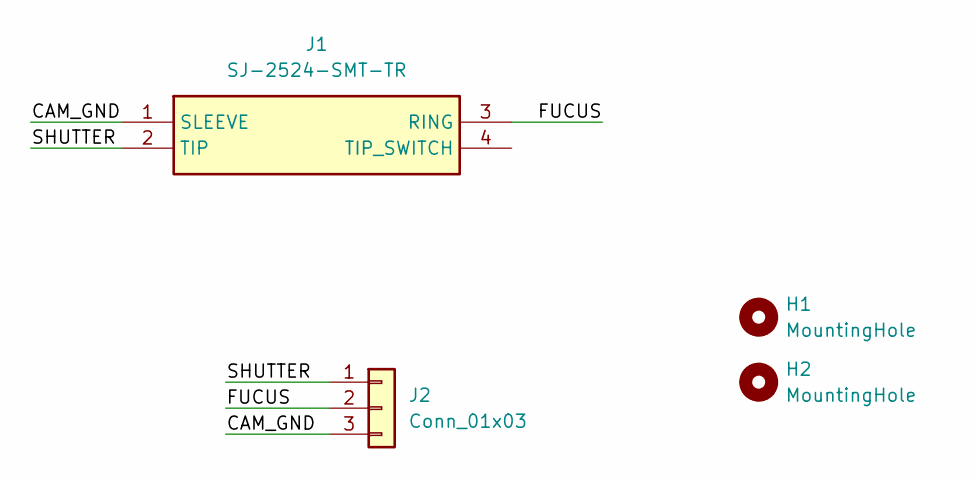
[picture p19: schematic Camera_connector_board.kicad_sch]

Parts:
H1, H2: MountingHole; MountingHole_3mm
J1: SJ-2524-SMT-TR; SJ2524SMTTR; Mouser Part Number 490-SJ-2524-SMT-TR
J2: Conn_01x03; JST_PH_B3B-PH-SM4-TB_1x03-1MP_P2.00mm_Vertical

Connections:
/CAM_GND: J1.1 (SLEEVE), J2.3
/FUCUS: J1.3 (RING), J2.2
/SHUTTER: J1.2 (TIP), J2.1

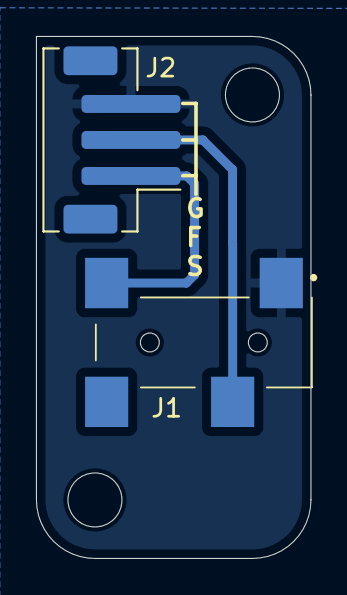
[picture p20: board Camera_connector_board.kicad_pcb from below]

Board: 2 copper layers, 15.2 x 29.0 mm, 4 parts (2 on the bottom side), 3 nets.
