PecaJosef/PCK-ST1/Hall effect endstop/PCK-HALL.kicad_pcb

## KiCad design Hall effect endstop/PCK-HALL.kicad_pcb (2026-01-14)

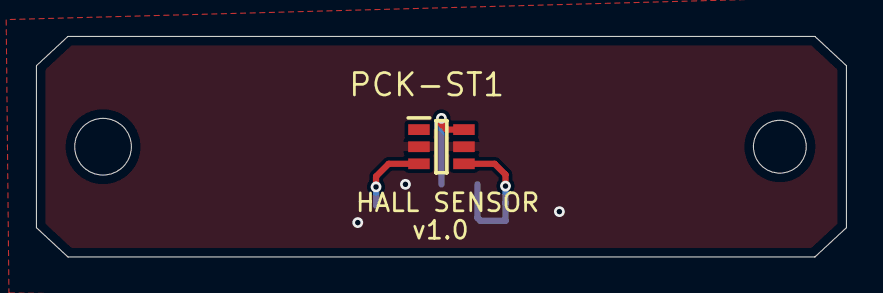
[picture p21: board PCK-HALL.kicad_pcb from above]

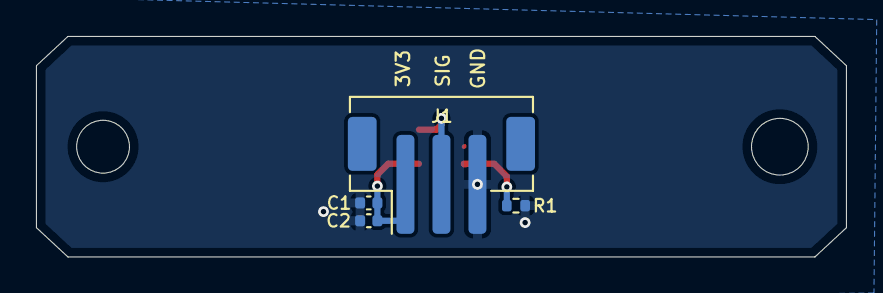
[picture p22: board PCK-HALL.kicad_pcb from below]

Board: 2 copper layers, 45.0 x 12.2 mm, 5 parts (4 on the bottom side), 4 nets.

Parts:
C1: 1uF; C_0402_1005Metric
C2: 100nF; C_0402_1005Metric
IC1: TMAG5328A1ZQDBVR; SOT95P280X145-6N
J1: Conn_01x03; JST_PH_B3B-PH-SM4-TB_1x03-1MP_P2.00mm_Vertical
R1: TBD; R_0402_1005Metric

Connections:
+3V3: C1.1, C2.1, IC1.4 (VCC), J1.1
GND: C1.2, C2.2, IC1.2 (GND), IC1.5 (TEST2), J1.3, R1.2
unnamed: IC1.3 (ADJ), R1.1
unnamed: IC1.6 (OUT), J1.2
