PecaJosef/PCK-ST1/STM32 Firmware/PCK-ST1/Core/Src/main.c

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
/* Includes ------------------------------------------------------------------*/
#include "main.h"
#include "usb_device.h"

/* USER CODE BEGIN Includes */
#include <string.h>
#include <stdio.h>

#include "timers.h"
#include "stepper.h"
#include "mag.h"
#include "gps.h"
#include "exti.h"
#include "usbd_cdc_if.h"
#include "wmm.h"
#include "control_loop.h"
#include "stdbool.h"
#include "cmd_handler.h"
#include "uart_it.h"
#include "telemetry.h"
#include "astro.h"
#include "camera.h"


/* USER CODE END Includes */

ADC_HandleTypeDef hadc1;
DMA_HandleTypeDef hdma_adc1;

I2C_HandleTypeDef hi2c3;

TIM_HandleTypeDef htim1;
TIM_HandleTypeDef htim2;
TIM_HandleTypeDef htim3;
TIM_HandleTypeDef htim5;
TIM_HandleTypeDef htim8;
TIM_HandleTypeDef htim16;
TIM_HandleTypeDef htim17;

UART_HandleTypeDef huart4;
UART_HandleTypeDef huart5;
UART_HandleTypeDef huart1;
DMA_HandleTypeDef hdma_uart4_rx;

void SystemClock_Config(void);
void PeriphCommonClock_Config(void);
static void MX_GPIO_Init(void);
static void MX_DMA_Init(void);
static void MX_I2C3_Init(void);
static void MX_UART4_Init(void);
static void MX_UART5_Init(void);
static void MX_USART1_UART_Init(void);
static void MX_TIM17_Init(void);
static void MX_TIM3_Init(void);
static void MX_TIM5_Init(void);
static void MX_TIM8_Init(void);
static void MX_TIM1_Init(void);
static void MX_TIM2_Init(void);
static void MX_ADC1_Init(void);
static void MX_TIM16_Init(void);
/**
  * @brief  The application entry point.
  * @retval int
  */
int main(void)
{

  /* MCU Configuration--------------------------------------------------------*/

  /* Reset of all peripherals, Initializes the Flash interface and the Systick. */
  HAL_Init();

  /* Configure the system clock */
  SystemClock_Config();

  /* Configure the peripherals common clocks */
  PeriphCommonClock_Config();

  /* Initialize all configured peripherals */
  MX_GPIO_Init();
  MX_DMA_Init();
  MX_I2C3_Init();
  MX_UART4_Init();
  MX_UART5_Init();
  MX_USART1_UART_Init();
  MX_TIM17_Init();
  MX_USB_DEVICE_Init();
  MX_TIM3_Init();
  MX_TIM5_Init();
  MX_TIM8_Init();
  MX_TIM1_Init();
  MX_TIM2_Init();
  MX_ADC1_Init();
  MX_TIM16_Init();
  /* Infinite loop */
  /* USER CODE BEGIN WHILE */

  stepperInit();
  Stepper_nSleep(GPIO_PIN_SET);
  Mag_Init(&hi2c3);
  commandHandler_Init();
  UART_IT_Init();
  GPS_Init_DMA();
  wmm_init();
  adcVoltageInit();
  cameraInit();

  ledsSet(0); //Turns LEDS off by default
  pwrButtonSet(1); //Turns Power button LED ON by default


  while (1)
  {
    /* USER CODE END WHILE */

    /* USER CODE BEGIN 3 */

	controlLoop();
	commandHandler();
	telemetryHandler();
	cameraHandler();

  }

  /* USER CODE END 3 */
}

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
