PecaJosef/PCK-ST1/STM32 Firmware/PCK-ST1/PCK-ST1.ioc

Mcu.UserName=STM32L476RGTx
PA0.Signal=UART4_TX
PA1.Signal=UART4_RX
PA10.Signal=USART1_RX
PA11.Signal=USB_OTG_FS_DM
PA12.Signal=USB_OTG_FS_DP
PA2.GPIO_Label=ALT_LIM
PA2.Signal=GPXTI2
PA3.GPIO_Label=DEC_LIM
PA3.Signal=GPXTI3
PA4.GPIO_Label=RA_LIM
PA4.Signal=GPXTI4
PA5.GPIO_Label=AZ_EN
PA5.Signal=GPIO_Output
PA6.GPIO_Label=AZ_DIR
PA6.Signal=GPIO_Output
PA7.GPIO_Label=AZ_STEP
PA7.Signal=GPIO_Output
PA9.Signal=USART1_TX
PB0.GPIO_Label=STEP_SLEEP_n
PB0.Signal=GPIO_Output
PB1.GPIO_Label=ALT_EN
PB1.Signal=GPIO_Output
PB10.GPIO_Label=ALT_STEP
PB10.Signal=GPIO_Output
PB11.GPIO_Label=ALT_FAULT_n
PB11.Signal=GPIO_Input
PB12.GPIO_Label=RA_EN
PB12.Signal=GPIO_Output
PB13.GPIO_Label=RA_DIR
PB13.Signal=GPIO_Output
PB14.GPIO_Label=RA_STEP
PB14.Signal=TIM1_CH2N
PB15.GPIO_Label=RA_FAULT_n
PB15.Signal=GPIO_Input
PB2.GPIO_Label=ALT_DIR
PB2.Signal=GPIO_Output
PB5.GPIO_Label=LED_DC
PB5.Signal=GPIO_Output
PB6.GPIO_Label=CAM_FOCUS
PB6.Signal=GPIO_Output
PB7.GPIO_Label=CAM_SHUTTER
PB7.Signal=GPIO_Output
PB8.GPIO_Label=RPI_PWR_EN
PB8.Signal=GPIO_Output
PB9.Signal=S_TIM17_CH1
PC0.Signal=I2C3_SCL
PC1.Signal=I2C3_SDA
PC10.GPIO_Label=LED2
PC10.Signal=GPIO_Output
PC11.GPIO_Label=LED1
PC11.Signal=GPIO_Output
PC12.Signal=UART5_TX
PC13.GPIO_Label=PWR_BTN_LED
PC13.Signal=GPIO_Output
PC3.Signal=ADCx_IN4
PC4.GPIO_Label=AZ_FAULT_n
PC4.Signal=GPIO_Input
PC6.GPIO_Label=DEC_EN
PC6.Signal=GPIO_Output
PC7.GPIO_Label=DEC_DIR
PC7.Signal=GPIO_Output
PC8.GPIO_Label=DEC_STEP
PC8.Signal=S_TIM8_CH3
PC9.GPIO_Label=DEC_FAULT_n
PC9.Signal=GPIO_Input
PD2.Signal=UART5_RX
