PecaJosef/PCK-ST1/STM32 Firmware/PCK-ST1/Core/Inc/main.h

#define PWR_BTN_LED_Pin GPIO_PIN_13
#define PWR_BTN_LED_GPIO_Port GPIOC
#define PWR_BTN_Pin GPIO_PIN_14
#define PWR_BTN_GPIO_Port GPIOC
#define AZ_LIM_Pin GPIO_PIN_15
#define AZ_LIM_GPIO_Port GPIOC
#define ALT_LIM_Pin GPIO_PIN_2
#define ALT_LIM_GPIO_Port GPIOA
#define ALT_LIM_EXTI_IRQn EXTI2_IRQn
#define DEC_LIM_Pin GPIO_PIN_3
#define DEC_LIM_GPIO_Port GPIOA
#define DEC_LIM_EXTI_IRQn EXTI3_IRQn
#define RA_LIM_Pin GPIO_PIN_4
#define RA_LIM_GPIO_Port GPIOA
#define RA_LIM_EXTI_IRQn EXTI4_IRQn
#define AZ_EN_Pin GPIO_PIN_5
#define AZ_EN_GPIO_Port GPIOA
#define AZ_DIR_Pin GPIO_PIN_6
#define AZ_DIR_GPIO_Port GPIOA
#define AZ_STEP_Pin GPIO_PIN_7
#define AZ_STEP_GPIO_Port GPIOA
#define AZ_FAULT_n_Pin GPIO_PIN_4
#define AZ_FAULT_n_GPIO_Port GPIOC
#define STEP_SLEEP_n_Pin GPIO_PIN_0
#define STEP_SLEEP_n_GPIO_Port GPIOB
#define ALT_EN_Pin GPIO_PIN_1
#define ALT_EN_GPIO_Port GPIOB
#define ALT_DIR_Pin GPIO_PIN_2
#define ALT_DIR_GPIO_Port GPIOB
#define ALT_STEP_Pin GPIO_PIN_10
#define ALT_STEP_GPIO_Port GPIOB
#define ALT_FAULT_n_Pin GPIO_PIN_11
#define ALT_FAULT_n_GPIO_Port GPIOB
#define RA_EN_Pin GPIO_PIN_12
#define RA_EN_GPIO_Port GPIOB
#define RA_DIR_Pin GPIO_PIN_13
#define RA_DIR_GPIO_Port GPIOB
#define RA_STEP_Pin GPIO_PIN_14
#define RA_STEP_GPIO_Port GPIOB
#define RA_FAULT_n_Pin GPIO_PIN_15
#define RA_FAULT_n_GPIO_Port GPIOB
#define DEC_EN_Pin GPIO_PIN_6
#define DEC_EN_GPIO_Port GPIOC
#define DEC_DIR_Pin GPIO_PIN_7
#define DEC_DIR_GPIO_Port GPIOC
#define DEC_STEP_Pin GPIO_PIN_8
#define DEC_STEP_GPIO_Port GPIOC
#define DEC_FAULT_n_Pin GPIO_PIN_9
#define DEC_FAULT_n_GPIO_Port GPIOC
#define LED4_Pin GPIO_PIN_14
#define LED4_GPIO_Port GPIOA
#define LED3_Pin GPIO_PIN_15
#define LED3_GPIO_Port GPIOA
#define LED2_Pin GPIO_PIN_10
#define LED2_GPIO_Port GPIOC
#define LED1_Pin GPIO_PIN_11
#define LED1_GPIO_Port GPIOC
#define PWR_STATE_Pin GPIO_PIN_3
#define PWR_STATE_GPIO_Port GPIOB
#define LED_USB_Pin GPIO_PIN_4
#define LED_USB_GPIO_Port GPIOB
#define LED_DC_Pin GPIO_PIN_5
#define LED_DC_GPIO_Port GPIOB
#define CAM_FOCUS_Pin GPIO_PIN_6
#define CAM_FOCUS_GPIO_Port GPIOB
#define CAM_SHUTTER_Pin GPIO_PIN_7
#define CAM_SHUTTER_GPIO_Port GPIOB
#define RPI_PWR_EN_Pin GPIO_PIN_8
#define RPI_PWR_EN_GPIO_Port GPIOB
