PecaJosef/PCK-ST1/STM32 Firmware/PCK-ST1/Core/Inc/gps.h

/*
 * gps.h
 *
 *  Created on: Aug 15, 2025
 *      Author: pecka
 */

#ifndef INC_GPS_H_
#define INC_GPS_H_

#include "main.h"
#include "string.h"
#include "stdlib.h"
#include "stdio.h"
#include "math.h"
#include "stdbool.h"

typedef struct {
    double latitude;       	// decimal degrees
    double longitude;      	// decimal degrees
    float altitude;        	// meters
    uint8_t satellites;    	// number of satellites in use
    float hdop;            	// horizontal dilution of precision
    uint8_t fix;           	// 0 = no fix, 1 = GPS fix
    char time[16];         	// UTC time hhmmss.sss
    uint8_t year;			// Year in yy format
    uint8_t month;			// Month in mm format
    uint8_t day;			// Day in dd format
} GPS_Data_t;


//UBX-ACK-ACK:  B5 62 05 01 02 00 06 8A 98 44
//UBX-ACK-NAK:  B5 62 05 00 02 00 06 8A 97 43
typedef enum {
    GPS_ACK_PENDING,
    GPS_ACK_OK,
    GPS_ACK_NAK,
} GPS_Ack_t;


#define GPS_UART &huart4 //GPS UART Handler
#define GPS_DMA_RX_BUF_SIZE 512

//#define GPS_DEBUG

void GPS_Init_DMA(void);

GPS_Data_t getGPSData(void);

void gpsConfig(void);

void gpsFlushBuffer();

bool gpsIsAlive();

GPS_Ack_t gpsCheckAck(void);

bool GPS_ValidFix();

#endif /* INC_GPS_H_ */
