PecaJosef/PCK-ST1/RPi Zero Software/pckdev/commandprocessing.py

from camera import captureImage
from star_processing import getAlignmentError
import math
import subprocess
from time import sleep

import cv2

def alignmentError(uart):
    star_image = cv2.imread("star_img/polaris4_1.jpg")
    #star_image = captureImage(5,16,True) #10s exposure, 16 gain, flip the image
    NCPErrorX, NCPErrorY, polarisFound, PAsuccesful = getAlignmentError(star_image)

    pae_msg = f"#PA:DEV:{int(PAsuccesful)}:{int(polarisFound)}:{NCPErrorX:.5f}:{NCPErrorY:.5f}"
    uart.send(pae_msg)
    return

def rpiShutdown(uart):
    print("[SYSTEM] Shutting down Raspberry Pi...")
    uart.send("#SHUTDOWN:OK")
    time.sleep(0.25)
    subprocess.run(["sudo", "shutdown", "-h", "now"],check=False)
