PecaJosef/PCK-ST1/(commit log)

2025-07-26 Added FW
    [untitled.kicad_sch]
2025-08-05 Added stepper control
2025-08-15 Updated resistor values
    [untitled.kicad_sch]
2025-08-16 Updated endstops routing
    [PCK-ST1.kicad_pcb, untitled.kicad_sch]
2025-08-16 Added GPS and started homing functions
2025-08-28 Power up idle, warm up state almost done
2025-09-10 Updated homing cycle
2025-09-13 Updated layout v0.2
    [PCK-ST1.kicad_pcb]
2025-10-04 As built update
    [PCK-HALL.kicad_sch]
2025-10-04 As built updated
    [PCK-ST1.csv, PCK-ST1.kicad_pcb, PCK-ST1.kicad_sch]
2025-10-10 UART commands
2025-12-23 Added STEP file
    [PCK-HALL.step]
2025-12-23 Main board updated to v0.3
    [PCK-ST1.kicad_pcb, PCK-ST1.kicad_sch, Power.kicad_sch, Stepper.kicad_sch, untitled.kicad_sch]
2025-12-26 pd s nma update
    [Power_delivery.kicad_sch]
2026-01-03 schema updated
    [PCK-ST1.kicad_sch, Stepper.kicad_sch]
2026-01-14 Added JST PH connector 3D model to the design
    [PCK-HALL.kicad_pcb, PCK-HALL.step]
2026-01-14 Added Camera remote shutter breakout board
    [Camera_connector_board.kicad_pcb, Camera_connector_board.kicad_sch, Camera_connector_board.step]
2026-01-18 Main board v0.3 to be manufactured
    [PCK-ST1.kicad_pcb, Power_delivery.kicad_sch, untitled.kicad_sch]
2026-01-18 V1.0 - manufacturing
    [Camera_connector_board.kicad_pcb]
2026-02-03 Added part numbers for simpler ordering
    [PCK-ST1.kicad_sch, Power.kicad_sch, Power_delivery.kicad_sch, Stepper.kicad_sch, untitled.kicad_sch]
2026-02-07 Rough alignment procedure prototype
2026-02-13 As built v0.3
    [PCK-ST1.step, PCK-ST1.stl, PCK-ST1_V2.step]
2026-02-14 Fixed camera behavior
2026-02-14 Updated Main board to v1.0
    [PCK-ST1.kicad_pcb, PCK-ST1.kicad_sch, untitled.kicad_sch]
2026-02-14 Creted new version of flex PCB for PA camera
    [PCK_Flex.kicad_pcb, PCK_Flex.kicad_sch, PCK_Flex.step]
2026-02-14 Created connector board for RPi connection and easier wiring
    [Connector_board.kicad_pcb, Connector_board.kicad_sch, Connector_board.step]
2026-02-15 Fixed long camera delay
    [camera.py]
2026-02-15 Fixed error with starless images
    [star_processing.py]
2026-02-17 Updated image processing to reduce noise and overall brightness impact
    [star_processing.py]
2026-03-07 Fixed errors in star_processing.py
    [star_processing.py]
2026-03-09 Updated star_processing.py, fixed some minor issues
    [cmdprocessing.py, star_processing.py]
2026-03-15 Updated to v2.1
    [PCK_Flex.kicad_pcb, PCK_Flex.kicad_sch, PCK_Flex.step]
2026-03-15 Added R1 pull-up to RPI_PWR_EN
    [PCK-ST1.kicad_pcb, Power.kicad_sch]
2026-03-19 Updated V1.0 schematic values
    [PCK-ST1.kicad_sch, untitled.kicad_sch]
2026-03-19 Updated to V0.2
    [Connector_board.kicad_pcb, Connector_board.kicad_sch, Connector_board.step]
2026-03-19 Added ALT, RA, DEC axis homing
2026-04-03 Fixed CoR None issue
    [main.py, star_processing.py]
2026-04-04 Added CoR command handling, added HOMING, ALIGNING, TEST ALIGNING and ALIBRATING commands for switching states
2026-04-13 Added astro coordinates tracking, goto fucntion and camera control Testing version
2026-04-16 Tracking logic updated
    [untitled.kicad_sch]
2026-04-16 Updated power off commands
2026-04-18 Renamed MCU sheet
    [MCU.kicad_sch, PCK-ST1.kicad_sch]
2026-05-01 Updated goto updating wrongly
    [astro.c, control_loop.c]
2026-05-01 sch update
    [MCU.kicad_sch, PCK-ST1.kicad_sch, Power.kicad_sch, Power_delivery.kicad_sch]
2026-08-17 Update continuous PA - added ALT/AZ error transformation based on physical RA angular position
    [control_loop.c]
2026-09-07 Fixed continuous PA flipped direction
    [control_loop.c]
2026-09-12 Dimensions draft
    [Controller_board.kicad_pcb, Controller_board.kicad_sch]
2026-09-21 Power schematic
    [Controller_board.kicad_pcb]
2026-10-06 Added v0.1 build
    [Controller_board.kicad_pcb, Controller_board.kicad_sch, MCU.kicad_sch, Power.kicad_sch]
2026-10-06 Added encoder board
    [Scrollwheel_board.kicad_pcb, Scrollwheel_board.kicad_sch]
2026-10-06 Fixed image size bug
    [star_processing.py]
2026-10-08 Moved PCK-HC to new repo
    [Controller_board.kicad_pcb, Controller_board.kicad_sch, MCU.kicad_sch, Power.kicad_sch, Scrollwheel_board.kicad_pcb, Scrollwheel_board.kicad_sch]
