PecaJosef/PCK-ST1/(notices)

Notices in the files:
STM32 Firmware/PCK-ST1/Core/Inc/main.h:
Copyright (c) 2025 STMicroelectronics.
All rights reserved.
This software is licensed under terms that can be found in the LICENSE file
